lefty01/ESP32_TTGO_FTMS/doc/esp32_treadmill_sensor_proto.jpg

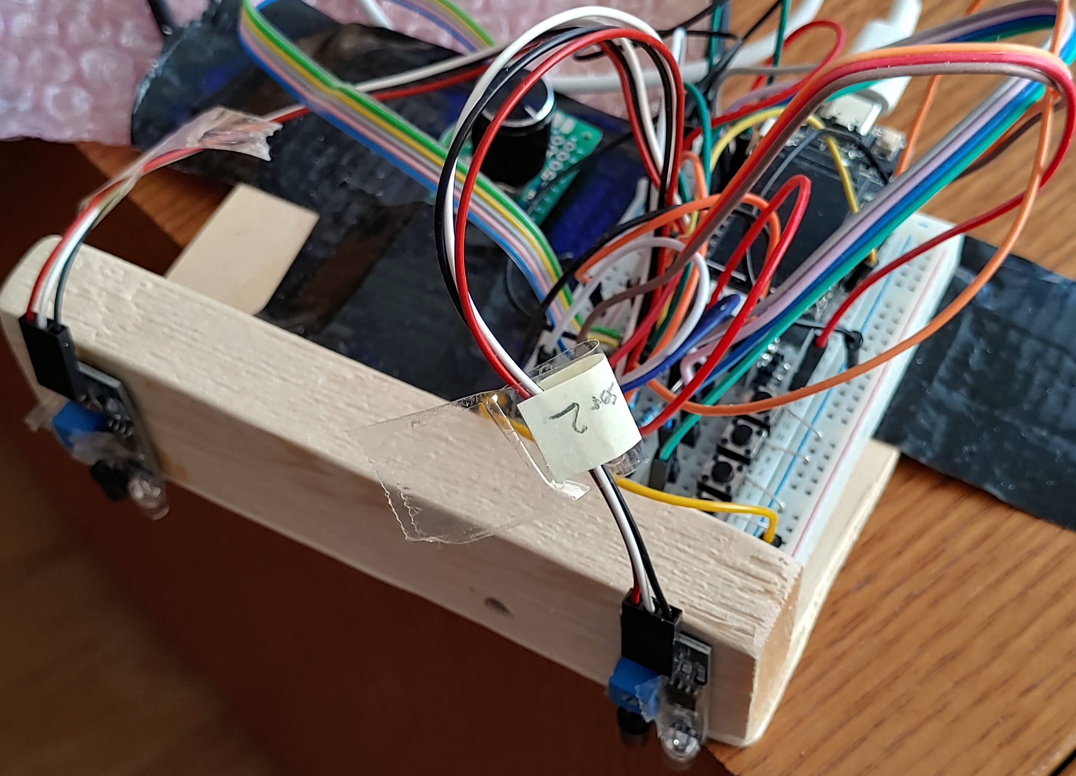
doc/esp32_treadmill_sensor_proto.jpg
