lefty01/ESP32_TTGO_FTMS/doc/taurus_incline_angle.png

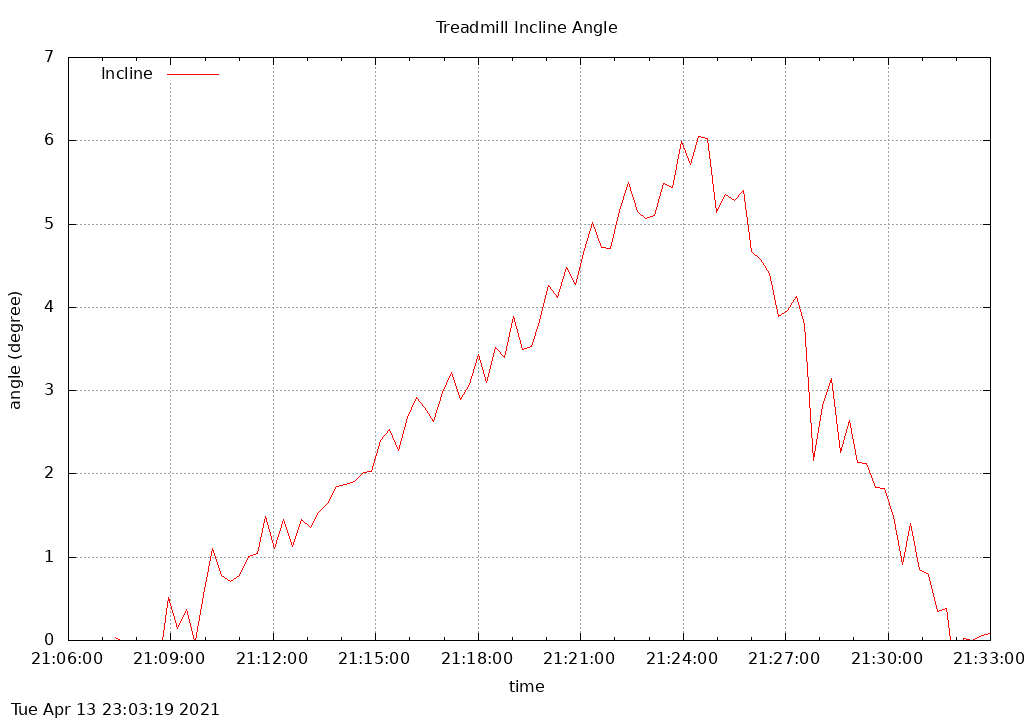
doc/taurus_incline_angle.png
