lefty01/ESP32_TTGO_FTMS/doc/taurus_incline_dist_tof.png

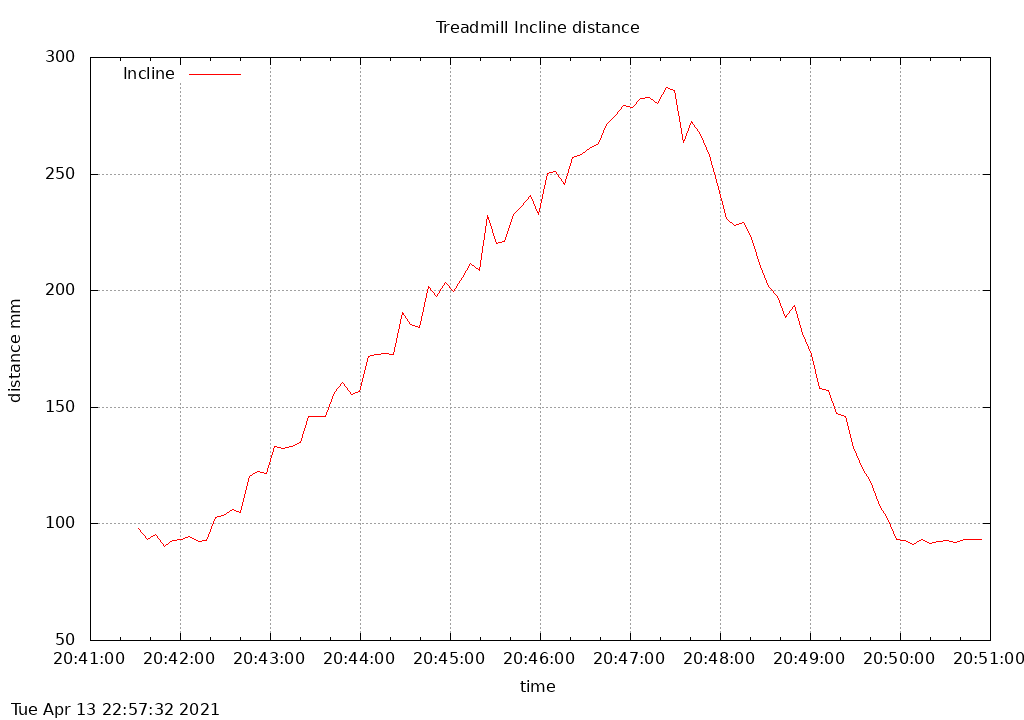
doc/taurus_incline_dist_tof.png
