lefty01/ESP32_TTGO_FTMS/doc/measurement-kmh-vs-time.ods

Sheet: Sheet1
Speed [km/h] | Time [ms] | Distance [] | Speed [m/s] | Time [s] | Dist [m] | mm | us | P | f | t high | t low
22 | 40.8 | 897.6 | 6.11 | 0.0408 | 0.249333333333333 |  | 40800
20 | 45 | 900 | 5.56 | 0.045 | 0.25 |  | 45000
16 | 56 | 896 | 4.44 | 0.056 | 0.248888888888889 |  | 56000
12 | 76 | 912 | 3.33 | 0.076 | 0.253333333333333 |  | 76000
10 | 90.4 | 904 | 2.78 | 0.0904 | 0.251111111111111 |  | 90400
8 | 112.8 | 902.4 | 2.22 | 0.1128 | 0.250666666666666 |  | 112800
4 | 225 | 900 | 1.11 | 0.225 | 0.25 |  | 225000
2 | 450 | 900 | 0.56 | 0.45 | 0.25 |  | 450000
1 | 900 | 900 | 0.28 | 0.9 | 0.25 |  | 900000
0.5 | 1840 | 920 | 0.14 | 1.84 | 0.255555555555556 |  | 1840000
 |  |  |  |  | 0.250888888888889 | 250.888888888889

Sheet: Sheet2
25378510
25557209 | 178699
25557210 | 1
25557212 | 2
25557237 | 25
27205747 | 1648510
27386274 | 180527
27386291 | 17
