lefty01/ESP32_TTGO_FTMS/(threads)

Thread 4 (2021-08-02):

MPU6050 init fail caused constant 15% incline to be reported

lefty01, 2021-08-02:
if MPU6050 fails to init we are able to manually set elevation ( that basically works,) but in my case it reported constant 15% incline which I didn't notice ... check the code!

lefty01, 2023-01-06:
so I think this is also not an issue anymore. if something pops up again lets open a new issue

Closed 2023-01-06.

Thread 14 (2022-02-03):

Building the Project - slight problems

Joeee83, 2022-02-03:
Hi there,
i just ordered a threadmill, but it is without bluetooth support. So i searched the internet and found this great project.
All the eletronic parts are here, so I started out by following your beginners guide. In addition to that I added a profile for my threadmill. (Without the real diameter for the roll)
So far its just the TTGO ESP32 running the website, connecting to my mqtt server. All working fine. The next thing I tried was to connect it to my smartphone (S10+) via BLE. In the Bluetooth settings i can connect the android os to the module. But I can't find the threadmill in an app. (zwift nor kinomap)
What am i doing wrong?
Do sensors have to be connected befor connecting to the software?
Any help is apreciated. TIA

Joe

lefty01, 2022-02-03:
Hi, nope the BLE server part should work regardless of any sensors. That's how I started just adjusting the speed and incline manually ( cumbersome but works).
So that said it's hard to predict what might be wrong. Are you running zwift on the android? It will tell you to turn on location server I guess you did that?
What I used in the beginning was the nrf connect app:
https://play.google.com/store/apps/details?id=no.nordicsemi.android.mcp&hl=en_US&gl=US
you can try this first and see if it connects to the ESP32 (shoud advertise as FTMS something)
if you can connect via this app you should be able to read speed for example as shown here:

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

if that does not work ... it's hard to predict ... I would then try to add some debug with this function:
void initBLE() {
...
  tft.println("initBLE");
...
and see if there's any error in setting up bluetooth.

are you using the (now default) NimbleBLE ... you would unless you undefined it in the source.

lefty01, 2022-02-03:
cool. also interesting you can see your treadmill as BT device, which model is it btw?

as for the "rotation" sensor ... usually you should be able to open the motor "room" of your treadmill ... also required to clean up the dust in there once in a while.  most likely you will see the motor that drives the front belt wheel via some strap. within that belt wheel there's usually one or even two magnets ... then there is the reed switch with some cable going to the control unit.
that is the thing detecting each wheel turn. I can see two options here a) use the existing sensor and use wires in parallel
or b) what I did buy extra reed sensor and mount it next to the existing one ( I used some hot glue) I have some 10k pull-up resistor that connects one wire of the sensor to the gpio pin.
hint: google image search treadmill speed sensor

before that I used the two IR-Sensors and had marked the belt (same concept as the RunN sensor) that should work as well ... but it's a  more "shaky" then the reed sensor readings.

let me know how things are going. so maybe we can close this issue? just open new one for anything that pops up.

zingo, 2022-02-03:
On my treadmill a Northtrack 12.2 Si, but this will probably be true for all MC2100ELS based models (a popular motor control board) the "rotation" sensor data is going up to the "CPU/Computer" in the console as one of the cables in the harnest as a 5V signal. In my case I just did a Y split of the cable and used a levelshifter from 5v to 3.3V and then connected it to the ESP32.

Joeee83, 2022-02-04:
Hi, yesterday i did some diggin.
The threadmill is a Hometrack HT5000 sold and branded by Miweba in Germany.
I first opend the Motor compartment. As expected from a chinese product wire handling looks a bit wild west, but is surely practical.  (A few connectors needed a push to sit right were they belong.)
The controller PCB is  a JFDZ_PBJ_XKYS_COMST _ V 1,17 and can also be bough as a spare from ali. Only the inclination seems to have a closed loop design. For the drive motor i can't see any feedback to the pcb. But the DC labeled motor has dual shafts. On one side there is a poly-V-belt and on the other side ther is a slotted disc. I can also see 2xM4 in the motors die cast housing for attaching a light barrier to it. This would be a managable job for me, as i can design and print 3d FDM parts. But doing so would give a much higher frequency of interrupts to the ESP. As i didn't find a bluetooth chip in there i had a look at the user interface PCB in the top of the machine.
It is build like a configurable motherboard for different modules with the display on its back. On the PCB there is: A Chip for determining the pulse of the user(SH601), a 32k Flash (HC16LC16) , a RAM Mapping 48x8 LCD Controller (HT1623) some audio and level shifting stuff as well as a BLE SoC CMT4502 from HOPERF. Its connector is labeld as GND, RX, TX, GND. The foiled buttons seem to be connected in a 5x4 matrix style to the PCB. The controller PCB is connected by 5 wires.
From here I have to decide what to do:
I could try to sniff the serial line to the bluetooth module. This would surely be the most elegant way for a ble retrofit. It questionable if there is communcation when the app doesn't connect to it. The thing is - when I scan the QR code on the machine it forwards me to an app in the play store. I installed it but didn't allow permissions for the local files. So this doesn't work atm. It questionable if there is communcation when the app doesn't connect to it. Unless i find an older of my phones with ble but without my private files.
Goind the factory RXTX way has the risk of not understanding the communication but also doesn't seem to give me the real speed.

i think this could be closed as my connection problem to the project is solved. I could post updates on my attemp here if you like it.  You can decide.

lefty01, 2022-02-04:
Hey ... thanks a lot for sharing this info!  so if this project by any chance will further mature it's good to know more about different treadmill types.
from reading the treadmill description of this model it could very well be that the designed BT interface is kind of unidirectional such that the training app  sends speed and incline to the treadmill only. but would be kind of surprising if there's no return signal to get "real" incline/speed back to the app. at one point this sounds pretty cool as it could open up a whole bunch of new possibilities (eg. grab incline from zwift and forward to treadmill) without further wiring .... BUT maybe reversing the protocol isn't straight forward.

So is your thinking that you might see speed and incline values on the Tx pin? so eg. read serial line via an ESP32 and than transmit as fitness machine data?

lefty01, 2022-02-04:
... btw maybe we can use the wiki to document different treadmill models.

zingo, 2022-02-04:
Was thinking about the wiki also, it would be good for each new person to find the different findings and ideas to fix them.

Joeee83, 2022-02-04:
The advertisment states: "Mit ihr werden Werte wie die Laufgeschwindigkeit via Smartphone an Ihr individuelles Trainingsziel angepasst." With the app values as running speed are adjusted to your individual training goal via Smartphone. I also took pictures of the inner parts.

zingo, 2022-02-04:
Nice I see you have already started :) Do you want us to edit wiki's in out fork or directly here, if so we need permission :)
Im not sure the wiki parts can be merged easy to/from forks but if it is I don't mind using the fork, whatever you think is best/easiest for you.

lefty01, 2022-02-04:
I would think it's easier to edit the wiki directly instead of forking it and add pull-requests. as collaborator you should have been able to edit it already ;)
I now removed the wiki access restriction so anyone with an github account should be able to edit/add pages.
... hoping there won't be offensive or otherwise inappropriate content being added.

zingo, 2022-02-04:
I didn't have any edit button before but it poped up now, thanks.
`... hoping there won't be offensive or otherwise inappropriate content being added.`
If that starts to happen we can always close it then.

lefty01, 2022-02-07:
closing ... as discussed

Closed 2022-02-07.

Thread 19 (2022-02-09):

Not able to pair with Zwift om computer

beer-rich, 2022-02-09:
Hi. I have used this with The Zwift Companion app on my phone successfully. But I am unable to get my computer to show the esp threadmill ingame. I have confirmed the PC has BLE and that ut is able to see the ESP in the "add bluetooth device wizard". Having ut on the computer would make it a lot easier to use for multiple users. Any help is appreciated.

lefty01, 2022-02-10:
Hi ... not sure if I can help. But how is you setting in the Zwift app on your PC (is it windows PC?)?
you can choose connect via built-in bluetooth or connect via Zwift companion.
On windows PC zwift I use the setting "built-in bluetooth" that works for me. I would think it is even a bit more "stable" connection then with my android phone.

have you played with these two options within zwift?  IIRC I did not pair the ESP with windows (like adding a bt device or something ... so maybe  you can try unpari from PC again then start Zwift and try use built-in bluetooth?? )

beer-rich, 2022-02-10:
Thanks for the quick reply and confirming this should work.

Yeah, its set to built in - I can pair with Heart Rate BLE Strap for instance.

I tried playing with unpairing/paring etc., but no difference.

Probably something with my computer then atleast.
Do you see the same BLE capabilites on your bluetooth device on your computer that is working?

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

lefty01, 2022-02-14:
as far as I can see this looks same here.

lefty01, 2022-02-17:
any success? any chance to try another PC and/or ESP board? not sure if you could enable some ESP Core debug function that could help debug the connection issue. or maybe some debug  prints  within the bluetooth code?
one other thing that came to my mind since I was wondering if we could cleanup the bluetooth and stick with only the "NimBLE" stack ... at this point you might be able to undefine NIMBLE in the code an run with the BLEDevice instead of NimBLEDevice ... although I doubt that it would make a difference

beer-rich, 2022-03-23:
Finally got to try with another ESP board and I have no issues now. Closing the issue.

lefty01, 2022-03-27:
cool thx for the update

Closed 2022-03-23.

Thread 24 (2022-07-28):

[Feature request] Adding RSCP (foot-pod) broadcast mode?

fyksen, 2022-07-28:
Hello. Love this project!
Some people don't want to use Zwift, but want to track distance on garmin watches. Garmin does not support FTMS from treadmill, so many people are left buying devices like the bulky and pricy NPE runn.

Would it be possible to add a feature that just sends [RSCP](https://www.bluetooth.org/docman/handlers/downloaddoc.ashx?doc_id=261266)

lefty01, 2022-08-01:
interesting point, right now I still use my garmin to record (and transmit to zwift) cadence for example .. and in virtual running mode (same as for the treadmill mode I think) the watch  records the pace that it measures from the arm movement.

so basically I already thought of having this ESP32 FTMS  measure cadence as well (but with the MPU6050 it should not be a big deal) and then also transmit the speed back to garmin watch....

as time permits I will take a closer look at this.

fyksen, 2022-08-17:
Very cool. Thanks!

lefty01, 2023-01-06:
sorry still pending.
but I really would like to add cadence any way at some point in time.
right now we are doing some (re-) work on this project anyway so maybe that helps keep up the pace ;))

fyksen, 2023-01-07:
No problem! Thanks for the update!

MartinGranados, 2024-09-27:
Hello, any update on this?

Im using a more basic version of this project, and it advertises itself as a footpad. Zwift supports the footpad, and my Garmin Tactix Delta (aka Fenix 6 series) can find it.

One benefit of the FTMS mode is that it can also pair with the Peloton app and display metrics on the apps workout display

I want my wife to be able to use the treadmill with peloton, and occasionally I will use the treadmill with Zwift, but sometimes id like to just run with music and a tv show on and just record straight to my watch.

Im wondering if its possible to have the one device broadcast multiple services so that for example, my watch can connect to the footpath (Run Speed/Cadence service) while Zwift or Peloton connect to the FTMS service

If this was python I could help, but I never learned C unfortunately haha so although I can KINDA poke around and figure things out, I sometimes mess the whole thing up and have to Ctrl-Z it all away

Thread 25 (2022-09-20):

more thanone instance of overloaded function "TwoWire::begin matches the argument list

smitec11, 2022-09-20:
in ESP32_TTGO_FTMS.cpp line 1101:

I2C_0.begin(SDA_0 , SCL_0 , I2C_FREQ);

will give error when building.

should be :

I2C_0.begin(SDA_0 , SCL_0 , (uint32_t) I2C_FREQ);

zingo, 2022-09-20:
Thanks for reporting!
I made this on my fork
https://github.com/zingo/ESP32_TTGO_FTMS/commit/6f0deaaba267e80c204e0c5f4158d71cfe72a7b8
a while ago I think it will solve this for you.

I created this pull request for this repo
https://github.com/lefty01/ESP32_TTGO_FTMS/pull/26

smitec11, 2022-09-20:
welcome.

can you contact me on the pm I send you? regards, Chris

zingo, 2022-09-20:
No problem but I can't find it but I also have not used PM in github before :)
Is the one in gitter from 22 Aug?
https://gitter.im/lefty01/ESP32_TTGO_FTMS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

lefty01, 2022-09-21:
merged #26
@zingo also note this commit: https://github.com/lefty01/ESP32_TTGO_FTMS/commit/cd9e4a1a89b27e7d2adb48c9d349f63fd03d7649
fixes the same issue for tagert ttgo-T4

smitec11, 2022-09-22:
@zingo,  I used gitter for the PM.

Closed 2022-09-21.

Thread 36 (2024-11-30):

Build failures 'SemaphoreHandle_t' does not name a type

cprasmu, 2024-11-30:
I'm guessing this is due to the boad api changes over time but I'm getting error: 'SemaphoreHandle_t' does not name a type. when trying to build. I also found that the AsyncElegantOTA library has been deprecated for ElegantOTA - I'm not sure if any code changes are required to move to this library?

lefty01, 2024-11-30:
Hrmm...good point. Since my device works pretty well there was not much need to keep track of lib updates. But I'll check if switching ota lib could be done without too much effort.

cprasmu, 2024-11-30:
Thanks that would be great!

Peter

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

cprasmu, 2024-12-02:
It’s the TTGO T-Display  esp32 , not home at the moment but just tried to
build from the pio build menu.

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

lefty01, 2024-12-02:
I tried switching to ElegantOTA here
https://github.com/lefty01/ESP32_TTGO_FTMS/tree/libupdate_dev
for me I think the targets are at least compiling. maybe you could try checkout that branch.
but you probably need to remove .pio completly (at least libdeps)
there's some issue with ESPAsyncWebServer-esphome vs ESPAsyncWebServer (not sure why we had -esphome version in the first place maybe I wanted homeassitant mqtt config or something like that???) if ESPAsyncWebServer-esphome is used then I think ESPAsyncWebServer is still downloaded as dependency and that cause error that some stuff is defined twice.
but I have not flashed anything and therefore not tested ota or if it works at all
```
Environment                  Status    Duration
---------------------------  --------  ------------
ESP32_TTGO_DISPLAY           SUCCESS   00:00:32.024
ESP32_TTGO_DISPLAY_SSL       SUCCESS   00:00:32.767
ESP32_WT32-SC01              SUCCESS   00:00:32.779
ESP32_WT32-SC01_OLD_TFT_GUI  SUCCESS   00:00:25.911
ESP32_TTGO_T4                SUCCESS   00:00:49.079
ESP32_WROOMD_HEADLESS        SUCCESS   00:00:18.313
```

lefty01, 2024-12-02:
if you see the SemaphoreHandle_t build error can you paste the complete compile output?

cprasmu, 2024-12-03:
I'm not sure if I have something wrong on my machine, but this is the output of just trying to build the ESP32_TTGO_DISPLAY target. building in vscode on macos Sequoia 15.0.1, 3.7 GHz 6-Core Intel Core i5

 *  Executing task: platformio run --environment ESP32_TTGO_DISPLAY

Processing ESP32_TTGO_DISPLAY (platform: espressif32; board: esp32dev; framework: arduino)
-----------------------------------------------------------------------------------------------------------------------------------------------------------------------------------------------------------------------------------------------------------------------------------
Verbose mode can be enabled via `-v, --verbose` option
CONFIGURATION: https://docs.platformio.org/page/boards/espressif32/esp32dev.html
PLATFORM: Espressif 32 (2023.12.10) > Espressif ESP32 Dev Module
HARDWARE: ESP32 240MHz, 320KB RAM, 4MB Flash
DEBUG: Current (cmsis-dap) External (cmsis-dap, esp-bridge, esp-prog, iot-bus-jtag, jlink, minimodule, olimex-arm-usb-ocd, olimex-arm-usb-ocd-h, olimex-arm-usb-tiny-h, olimex-jtag-tiny, tumpa)
PACKAGES:
 - framework-arduinoespressif32 @ 3.0.0
 - tool-cmake @ 3.21.3
 - tool-esptoolpy @ 1.40700.0+dev4 (4.7.0)
 - tool-mklittlefs @ 3.2.0
 - tool-mkspiffs @ 2.230.0 (2.30)
 - tool-ninja @ 1.9.0
 - tool-riscv32-esp-elf-gdb @ 12.1.0+20221002
 - tool-xtensa-esp-elf-gdb @ 12.1.0+20221002
 - toolchain-esp32ulp @ 1.23500.220830 (2.35.0)
 - toolchain-xtensa-esp32 @ 12.2.0+20230208
LDF: Library Dependency Finder -> https://bit.ly/configure-pio-ldf
LDF Modes: Finder ~ chain, Compatibility ~ soft
Found 35 compatible libraries
Scanning dependencies...
Dependency Graph
|-- NimBLE-Arduino @ 1.4.3
|-- PubSubClient @ 2.8.0
|-- ArduinoJson @ 6.21.5
|-- Button2 @ 2.3.3
|-- Time @ 1.6.1
|-- MPU6050_light @ 1.1.0
|-- ESPAsyncWiFiManager @ 0.31.0+sha.3b9a58a
|-- ElegantOTA @ 3.1.6
|-- LovyanGFX @ 1.2.0
|-- lvgl @ 8.4.0
|-- ESPAsyncWebServer @ 3.3.23
|-- AsyncTCP @ 3.2.14
|-- LittleFS @ 2.0.0
|-- Preferences @ 2.0.0
|-- SPI @ 2.0.0
|-- Wire @ 2.0.0
|-- DNSServer @ 2.0.0
|-- WiFi @ 2.0.0
Building in release mode
Compiling .pio/build/ESP32_TTGO_DISPLAY/lib62e/LovyanGFX/lgfx/Fonts/IPA/lgfx_font_japan.c.o
Compiling .pio/build/ESP32_TTGO_DISPLAY/lib62e/LovyanGFX/lgfx/Fonts/efont/lgfx_efont_cn.c.o
Compiling .pio/build/ESP32_TTGO_DISPLAY/lib62e/LovyanGFX/lgfx/Fonts/efont/lgfx_efont_ja.c.o
Compiling .pio/build/ESP32_TTGO_DISPLAY/lib62e/LovyanGFX/lgfx/Fonts/efont/lgfx_efont_kr.c.o
Compiling .pio/build/ESP32_TTGO_DISPLAY/lib62e/LovyanGFX/lgfx/Fonts/efont/lgfx_efont_tw.c.o
Compiling .pio/build/ESP32_TTGO_DISPLAY/lib62e/LovyanGFX/lgfx/utility/lgfx_miniz.c.o
Compiling .pio/build/ESP32_TTGO_DISPLAY/lib62e/LovyanGFX/lgfx/utility/lgfx_pngle.c.o
Compiling .pio/build/ESP32_TTGO_DISPLAY/lib62e/LovyanGFX/lgfx/utility/lgfx_qoi.c.o
Compiling .pio/build/ESP32_TTGO_DISPLAY/lib62e/LovyanGFX/lgfx/utility/lgfx_qrcode.c.o
Compiling .pio/build/ESP32_TTGO_DISPLAY/lib62e/LovyanGFX/lgfx/utility/lgfx_tjpgd.c.o
Compiling .pio/build/ESP32_TTGO_DISPLAY/lib62e/LovyanGFX/lgfx/v1/LGFXBase.cpp.o
Compiling .pio/build/ESP32_TTGO_DISPLAY/lib62e/LovyanGFX/lgfx/v1/LGFX_Button.cpp.o
Compiling .pio/build/ESP32_TTGO_DISPLAY/lib62e/LovyanGFX/lgfx/v1/LGFX_Sprite.cpp.o
Compiling .pio/build/ESP32_TTGO_DISPLAY/lib62e/LovyanGFX/lgfx/v1/lgfx_fonts.cpp.o
Compiling .pio/build/ESP32_TTGO_DISPLAY/lib62e/LovyanGFX/lgfx/v1/misc/DividedFrameBuffer.cpp.o
Compiling .pio/build/ESP32_TTGO_DISPLAY/lib62e/LovyanGFX/lgfx/v1/misc/SpriteBuffer.cpp.o
Compiling .pio/build/ESP32_TTGO_DISPLAY/lib62e/LovyanGFX/lgfx/v1/misc/common_function.cpp.o
Compiling .pio/build/ESP32_TTGO_DISPLAY/lib62e/LovyanGFX/lgfx/v1/misc/pixelcopy.cpp.o
Compiling .pio/build/ESP32_TTGO_DISPLAY/lib62e/LovyanGFX/lgfx/v1/panel/Panel_Device.cpp.o
Compiling .pio/build/ESP32_TTGO_DISPLAY/lib62e/LovyanGFX/lgfx/v1/panel/Panel_FlexibleFrameBuffer.cpp.o
Compiling .pio/build/ESP32_TTGO_DISPLAY/lib62e/LovyanGFX/lgfx/v1/panel/Panel_FrameBufferBase.cpp.o
Compiling .pio/build/ESP32_TTGO_DISPLAY/lib62e/LovyanGFX/lgfx/v1/panel/Panel_GDEW0154M09.cpp.o
Compiling .pio/build/ESP32_TTGO_DISPLAY/lib62e/LovyanGFX/lgfx/v1/panel/Panel_HUB75.cpp.o
Compiling .pio/build/ESP32_TTGO_DISPLAY/lib62e/LovyanGFX/lgfx/v1/panel/Panel_HasBuffer.cpp.o
Compiling .pio/build/ESP32_TTGO_DISPLAY/lib62e/LovyanGFX/lgfx/v1/panel/Panel_ILI9225.cpp.o
Compiling .pio/build/ESP32_TTGO_DISPLAY/lib62e/LovyanGFX/lgfx/v1/panel/Panel_IT8951.cpp.o
Compiling .pio/build/ESP32_TTGO_DISPLAY/lib62e/LovyanGFX/lgfx/v1/panel/Panel_LCD.cpp.o
Compiling .pio/build/ESP32_TTGO_DISPLAY/lib62e/LovyanGFX/lgfx/v1/panel/Panel_M5HDMI.cpp.o
Compiling .pio/build/ESP32_TTGO_DISPLAY/lib62e/LovyanGFX/lgfx/v1/panel/Panel_M5UnitGLASS.cpp.o
Compiling .pio/build/ESP32_TTGO_DISPLAY/lib62e/LovyanGFX/lgfx/v1/panel/Panel_M5UnitLCD.cpp.o
Compiling .pio/build/ESP32_TTGO_DISPLAY/lib62e/LovyanGFX/lgfx/v1/panel/Panel_NT35510.cpp.o
Compiling .pio/build/ESP32_TTGO_DISPLAY/lib62e/LovyanGFX/lgfx/v1/panel/Panel_RA8875.cpp.o
Compiling .pio/build/ESP32_TTGO_DISPLAY/lib62e/LovyanGFX/lgfx/v1/panel/Panel_RM68120.cpp.o
Compiling .pio/build/ESP32_TTGO_DISPLAY/lib62e/LovyanGFX/lgfx/v1/panel/Panel_SSD1306.cpp.o
Compiling .pio/build/ESP32_TTGO_DISPLAY/lib62e/LovyanGFX/lgfx/v1/panel/Panel_SSD1327.cpp.o
Compiling .pio/build/ESP32_TTGO_DISPLAY/lib62e/LovyanGFX/lgfx/v1/panel/Panel_SSD1331.cpp.o
Compiling .pio/build/ESP32_TTGO_DISPLAY/lib62e/LovyanGFX/lgfx/v1/panel/Panel_SSD1351.cpp.o
Compiling .pio/build/ESP32_TTGO_DISPLAY/lib62e/LovyanGFX/lgfx/v1/panel/Panel_SSD1963.cpp.o
Compiling .pio/build/ESP32_TTGO_DISPLAY/lib62e/LovyanGFX/lgfx/v1/platforms/arduino_default/Bus_SPI.cpp.o
Compiling .pio/build/ESP32_TTGO_DISPLAY/lib62e/LovyanGFX/lgfx/v1/platforms/arduino_default/Bus_Stream.cpp.o
Compiling .pio/build/ESP32_TTGO_DISPLAY/lib62e/LovyanGFX/lgfx/v1/platforms/arduino_default/common.cpp.o
Compiling .pio/build/ESP32_TTGO_DISPLAY/lib62e/LovyanGFX/lgfx/v1/platforms/esp32/Bus_HUB75.cpp.o
Compiling .pio/build/ESP32_TTGO_DISPLAY/lib62e/LovyanGFX/lgfx/v1/platforms/esp32/Bus_I2C.cpp.o
Compiling .pio/build/ESP32_TTGO_DISPLAY/lib62e/LovyanGFX/lgfx/v1/platforms/esp32/Bus_Parallel8.cpp.o
Compiling .pio/build/ESP32_TTGO_DISPLAY/lib62e/LovyanGFX/lgfx/v1/platforms/esp32/Bus_SPI.cpp.o
Compiling .pio/build/ESP32_TTGO_DISPLAY/lib62e/LovyanGFX/lgfx/v1/platforms/esp32/Light_PWM.cpp.o
Compiling .pio/build/ESP32_TTGO_DISPLAY/lib62e/LovyanGFX/lgfx/v1/platforms/esp32/Panel_CVBS.cpp.o
Compiling .pio/build/ESP32_TTGO_DISPLAY/lib62e/LovyanGFX/lgfx/v1/platforms/esp32/common.cpp.o
Compiling .pio/build/ESP32_TTGO_DISPLAY/lib62e/LovyanGFX/lgfx/v1/platforms/esp32c3/Bus_Parallel8.cpp.o
Compiling .pio/build/ESP32_TTGO_DISPLAY/lib62e/LovyanGFX/lgfx/v1/platforms/esp32s2/Bus_Parallel16.cpp.o
Compiling .pio/build/ESP32_TTGO_DISPLAY/lib62e/LovyanGFX/lgfx/v1/platforms/esp32s2/Bus_Parallel8.cpp.o
Compiling .pio/build/ESP32_TTGO_DISPLAY/lib62e/LovyanGFX/lgfx/v1/platforms/esp32s3/Bus_Parallel16.cpp.o
Compiling .pio/build/ESP32_TTGO_DISPLAY/lib62e/LovyanGFX/lgfx/v1/platforms/esp32s3/Bus_Parallel8.cpp.o
Compiling .pio/build/ESP32_TTGO_DISPLAY/lib62e/LovyanGFX/lgfx/v1/platforms/esp32s3/Bus_RGB.cpp.o
Compiling .pio/build/ESP32_TTGO_DISPLAY/lib62e/LovyanGFX/lgfx/v1/platforms/esp32s3/Panel_RGB.cpp.o
Compiling .pio/build/ESP32_TTGO_DISPLAY/lib62e/LovyanGFX/lgfx/v1/platforms/esp8266/Bus_I2C.cpp.o
Compiling .pio/build/ESP32_TTGO_DISPLAY/lib62e/LovyanGFX/lgfx/v1/platforms/esp8266/Bus_SPI.cpp.o
Compiling .pio/build/ESP32_TTGO_DISPLAY/lib62e/LovyanGFX/lgfx/v1/platforms/esp8266/common.cpp.o
Compiling .pio/build/ESP32_TTGO_DISPLAY/lib62e/LovyanGFX/lgfx/v1/platforms/framebuffer/Panel_fb.cpp.o
Compiling .pio/build/ESP32_TTGO_DISPLAY/lib62e/LovyanGFX/lgfx/v1/platforms/framebuffer/common.cpp.o
Compiling .pio/build/ESP32_TTGO_DISPLAY/lib62e/LovyanGFX/lgfx/v1/platforms/opencv/Panel_OpenCV.cpp.o
Compiling .pio/build/ESP32_TTGO_DISPLAY/lib62e/LovyanGFX/lgfx/v1/platforms/opencv/common.cpp.o
Compiling .pio/build/ESP32_TTGO_DISPLAY/lib62e/LovyanGFX/lgfx/v1/platforms/rp2040/Bus_I2C.cpp.o
Compiling .pio/build/ESP32_TTGO_DISPLAY/lib62e/LovyanGFX/lgfx/v1/platforms/rp2040/Bus_SPI.cpp.o
Compiling .pio/build/ESP32_TTGO_DISPLAY/lib62e/LovyanGFX/lgfx/v1/platforms/rp2040/Light_PWM.cpp.o
Compiling .pio/build/ESP32_TTGO_DISPLAY/lib62e/LovyanGFX/lgfx/v1/platforms/rp2040/common.cpp.o
Compiling .pio/build/ESP32_TTGO_DISPLAY/lib62e/LovyanGFX/lgfx/v1/platforms/samd21/Bus_I2C.cpp.o
Compiling .pio/build/ESP32_TTGO_DISPLAY/lib62e/LovyanGFX/lgfx/v1/platforms/samd21/Bus_SPI.cpp.o
Compiling .pio/build/ESP32_TTGO_DISPLAY/lib62e/LovyanGFX/lgfx/v1/platforms/samd21/common.cpp.o
Compiling .pio/build/ESP32_TTGO_DISPLAY/lib62e/LovyanGFX/lgfx/v1/platforms/samd51/Bus_I2C.cpp.o
Compiling .pio/build/ESP32_TTGO_DISPLAY/lib62e/LovyanGFX/lgfx/v1/platforms/samd51/Bus_SPI.cpp.o
Compiling .pio/build/ESP32_TTGO_DISPLAY/lib62e/LovyanGFX/lgfx/v1/platforms/samd51/common.cpp.o
Compiling .pio/build/ESP32_TTGO_DISPLAY/lib62e/LovyanGFX/lgfx/v1/platforms/sdl/Panel_sdl.cpp.o
Compiling .pio/build/ESP32_TTGO_DISPLAY/lib62e/LovyanGFX/lgfx/v1/platforms/sdl/common.cpp.o
Compiling .pio/build/ESP32_TTGO_DISPLAY/lib62e/LovyanGFX/lgfx/v1/platforms/spresense/Bus_SPI.cpp.o
Compiling .pio/build/ESP32_TTGO_DISPLAY/lib62e/LovyanGFX/lgfx/v1/platforms/spresense/common.cpp.o
Compiling .pio/build/ESP32_TTGO_DISPLAY/lib62e/LovyanGFX/lgfx/v1/platforms/stm32/Bus_SPI.cpp.o
Compiling .pio/build/ESP32_TTGO_DISPLAY/lib62e/LovyanGFX/lgfx/v1/platforms/stm32/common.cpp.o
Compiling .pio/build/ESP32_TTGO_DISPLAY/lib62e/LovyanGFX/lgfx/v1/touch/Touch_CST816S.cpp.o
Compiling .pio/build/ESP32_TTGO_DISPLAY/lib62e/LovyanGFX/lgfx/v1/touch/Touch_FT5x06.cpp.o
Compiling .pio/build/ESP32_TTGO_DISPLAY/lib62e/LovyanGFX/lgfx/v1/touch/Touch_GSLx680.cpp.o
Compiling .pio/build/ESP32_TTGO_DISPLAY/lib62e/LovyanGFX/lgfx/v1/touch/Touch_GT911.cpp.o
Compiling .pio/build/ESP32_TTGO_DISPLAY/lib62e/LovyanGFX/lgfx/v1/touch/Touch_NS2009.cpp.o
Compiling .pio/build/ESP32_TTGO_DISPLAY/lib62e/LovyanGFX/lgfx/v1/touch/Touch_RA8875.cpp.o
Compiling .pio/build/ESP32_TTGO_DISPLAY/lib62e/LovyanGFX/lgfx/v1/touch/Touch_STMPE610.cpp.o
Compiling .pio/build/ESP32_TTGO_DISPLAY/lib62e/LovyanGFX/lgfx/v1/touch/Touch_TT21xxx.cpp.o
Compiling .pio/build/ESP32_TTGO_DISPLAY/lib62e/LovyanGFX/lgfx/v1/touch/Touch_XPT2046.cpp.o
Compiling .pio/build/ESP32_TTGO_DISPLAY/src/ESP32_TTGO_FTMS.cpp.o
Compiling .pio/build/ESP32_TTGO_DISPLAY/src/config.cpp.o
Compiling .pio/build/ESP32_TTGO_DISPLAY/src/display.cpp.o
src/ESP32_TTGO_FTMS.cpp:66:2: warning: #warning todo cs:putback gfxlogtext [-Wcpp]
   66 | #warning todo cs:putback gfxlogtext
      |  ^~~~~~~
Compiling .pio/build/ESP32_TTGO_DISPLAY/src/gui-LVGL.cpp.o
Compiling .pio/build/ESP32_TTGO_DISPLAY/src/gui-tft.cpp.o
Compiling .pio/build/ESP32_TTGO_DISPLAY/src/hardware.cpp.o
In file included from src/display.cpp:2:
include/common.h:75:6: error: variable or field 'logText' declared void
   75 | void logText(std::string text);
      |      ^~~~~~~
include/common.h:75:19: error: 'string' is not a member of 'std'
   75 | void logText(std::string text);
      |                   ^~~~~~
include/common.h:1:1: note: 'std::string' is defined in header '<string>'; did you forget to '#include <string>'?
  +++ |+#include <string>
    1 | #ifndef _ESP32_TTGO_FTMS_H_
src/ESP32_TTGO_FTMS.cpp: In function 'void speedUp()':
src/ESP32_TTGO_FTMS.cpp:113:5: error: 'handleEvent' was not declared in this scope
  113 |     handleEvent(EventType::TREADMILL_SPEED_UP);
      |     ^~~~~~~~~~~
src/ESP32_TTGO_FTMS.cpp: In function 'void speedDown()':
src/ESP32_TTGO_FTMS.cpp:128:5: error: 'handleEvent' was not declared in this scope
  128 |     handleEvent(EventType::TREADMILL_SPEED_DOWN);
      |     ^~~~~~~~~~~
src/ESP32_TTGO_FTMS.cpp: In function 'void inclineUp()':
src/ESP32_TTGO_FTMS.cpp:143:5: error: 'handleEvent' was not declared in this scope
  143 |     handleEvent(EventType::TREADMILL_INC_UP);
      |     ^~~~~~~~~~~
src/ESP32_TTGO_FTMS.cpp: In function 'void inclineDown()':
src/ESP32_TTGO_FTMS.cpp:160:5: error: 'handleEvent' was not declared in this scope
  160 |     handleEvent(EventType::TREADMILL_INC_DOWN);
      |     ^~~~~~~~~~~
src/ESP32_TTGO_FTMS.cpp: In function 'void showInfo()':
src/ESP32_TTGO_FTMS.cpp:213:50: error: 'GPIOExtender' was not declared in this scope
  213 |              String(" GPIOExtender(AW9523): ") + GPIOExtender.isAvailable() + String("\n");
      |                                                  ^~~~~~~~~~~~
src/ESP32_TTGO_FTMS.cpp: In function 'void setup()':
src/ESP32_TTGO_FTMS.cpp:237:3: error: 'initButton' was not declared in this scope; did you mean 'initMqtt'?
  237 |   initButton();
      |   ^~~~~~~~~~
      |   initMqtt
src/ESP32_TTGO_FTMS.cpp:240:3: error: 'initHardware' was not declared in this scope; did you mean 'MockHardware'?
  240 |   initHardware();
      |   ^~~~~~~~~~~~
      |   MockHardware
src/ESP32_TTGO_FTMS.cpp: In function 'void loop()':
src/ESP32_TTGO_FTMS.cpp:261:3: error: 'loopHandleHardware' was not declared in this scope
  261 |   loopHandleHardware();
      |   ^~~~~~~~~~~~~~~~~~
src/hardware.cpp:249:2: warning: #warning todo cs: add gxloop handler again. [-Wcpp]
  249 | #warning todo cs: add gxloop handler again.
      |  ^~~~~~~
src/hardware.cpp:406:2: warning: #warning check out if this must be here ****************** [-Wcpp]
  406 | #warning check out if this must be here ******************
      |  ^~~~~~~
src/hardware.cpp:416:2: warning: #warning cs todo remove this [-Wcpp]
  416 | #warning cs todo remove this
      |  ^~~~~~~
src/hardware.cpp:448:2: warning: #warning remove this constant to some config/file [-Wcpp]
  448 | #warning remove this constant to some config/file
      |  ^~~~~~~
src/hardware.cpp:604:2: warning: #warning Remove delay and schedule last part later in some way and go back to "main" loop mode. [-Wcpp]
  604 | #warning Remove delay and schedule last part later in some way and go back to "main" loop mode.
      |  ^~~~~~~
src/hardware.cpp:620:2: warning: #warning Remove delay and schedule last part later in some way and go back to "main" loop mode. [-Wcpp]
  620 | #warning Remove delay and schedule last part later in some way and go back to "main" loop mode.
      |  ^~~~~~~
src/ESP32_TTGO_FTMS.cpp:262:3: error: 'loopHandleButton' was not declared in this scope; did you mean 'loopHandleBLE'?
  262 |   loopHandleButton();
      |   ^~~~~~~~~~~~~~~~
      |   loopHandleBLE
src/ESP32_TTGO_FTMS.cpp:268:7: error: 'timer_tick' was not declared in this scope; did you mean 'timer_t'?
  268 |   if (timer_tick == true) {
      |       ^~~~~~~~~~
      |       timer_t
src/ESP32_TTGO_FTMS.cpp:274:17: error: 'getIncline' was not declared in this scope; did you mean 'readIncline'?
  274 |       incline = getIncline(); // sets global 'angle' and 'incline' variable
      |                 ^~~~~~~~~~
      |                 readIncline
src/ESP32_TTGO_FTMS.cpp:289:21: error: 'calculateRPM' was not declared in this scope
  289 |         float rpm = calculateRPM();
      |                     ^~~~~~~~~~~~
Compiling .pio/build/ESP32_TTGO_DISPLAY/src/net-control.cpp.o
src/ESP32_TTGO_FTMS.cpp:292:25: error: 'workoutDistance' was not declared in this scope
  292 |         totalDistance = workoutDistance / 1000;   // conv mm to meter
      |                         ^~~~~~~~~~~~~~~
Building .pio/build/ESP32_TTGO_DISPLAY/bootloader.bin
esptool.py v4.7-dev
Creating esp32 image...
Merged 1 ELF section
Successfully created esp32 image.
Generating partitions .pio/build/ESP32_TTGO_DISPLAY/partitions.bin
*** [.pio/build/ESP32_TTGO_DISPLAY/src/ESP32_TTGO_FTMS.cpp.o] Error 1
*** [.pio/build/ESP32_TTGO_DISPLAY/src/display.cpp.o] Error 1
In file included from src/gui-LVGL.cpp:3:
include/common.h:75:6: error: variable or field 'logText' declared void
   75 | void logText(std::string text);
      |      ^~~~~~~
include/common.h:75:19: error: 'string' is not a member of 'std'
   75 | void logText(std::string text);
      |                   ^~~~~~
include/common.h:14:1: note: 'std::string' is defined in header '<string>'; did you forget to '#include <string>'?
   13 | #include <Arduino.h>
  +++ |+#include <string>
   14 |
In file included from src/hardware.cpp:28:
include/common.h:75:6: error: variable or field 'logText' declared void
   75 | void logText(std::string text);
      |      ^~~~~~~
include/common.h:75:19: error: 'string' is not a member of 'std'
   75 | void logText(std::string text);
      |                   ^~~~~~
include/common.h:1:1: note: 'std::string' is defined in header '<string>'; did you forget to '#include <string>'?
  +++ |+#include <string>
    1 | #ifndef _ESP32_TTGO_FTMS_H_
In file included from .pio/libdeps/ESP32_TTGO_DISPLAY/NimBLE-Arduino/src/NimBLEDevice.h:18,
                 from src/net-control.cpp:26:
.pio/libdeps/ESP32_TTGO_DISPLAY/NimBLE-Arduino/src/nimconfig.h:154: warning: "CONFIG_BT_NIMBLE_ROLE_CENTRAL" redefined
  154 | #define CONFIG_BT_NIMBLE_ROLE_CENTRAL
      |
In file included from /Users/userx/.platformio/packages/framework-arduinoespressif32@src-cdf0adb896be2b73de7b8a8d60c8dc56/tools/esp32-arduino-libs/esp32/include/newlib/platform_include/assert.h:12,
                 from /Users/userx/.platformio/packages/toolchain-xtensa-esp32/xtensa-esp32-elf/sys-include/sys/reent.h:503,
                 from /Users/userx/.platformio/packages/framework-arduinoespressif32@src-cdf0adb896be2b73de7b8a8d60c8dc56/tools/esp32-arduino-libs/esp32/include/newlib/platform_include/sys/reent.h:9,
                 from /Users/userx/.platformio/packages/toolchain-xtensa-esp32/xtensa-esp32-elf/sys-include/wchar.h:6,
                 from /Users/userx/.platformio/packages/toolchain-xtensa-esp32/xtensa-esp32-elf/include/c++/12.2.0/cwchar:44,
                 from /Users/userx/.platformio/packages/toolchain-xtensa-esp32/xtensa-esp32-elf/include/c++/12.2.0/bits/postypes.h:40,
                 from /Users/userx/.platformio/packages/toolchain-xtensa-esp32/xtensa-esp32-elf/include/c++/12.2.0/iosfwd:40,
                 from /Users/userx/.platformio/packages/toolchain-xtensa-esp32/xtensa-esp32-elf/include/c++/12.2.0/ios:38,
                 from /Users/userx/.platformio/packages/toolchain-xtensa-esp32/xtensa-esp32-elf/include/c++/12.2.0/ostream:38,
                 from /Users/userx/.platformio/packages/toolchain-xtensa-esp32/xtensa-esp32-elf/include/c++/12.2.0/bits/unique_ptr.h:41,
                 from /Users/userx/.platformio/packages/toolchain-xtensa-esp32/xtensa-esp32-elf/include/c++/12.2.0/memory:76,
                 from /Users/userx/.platformio/packages/framework-arduinoespressif32@src-cdf0adb896be2b73de7b8a8d60c8dc56/libraries/FS/src/FS.h:24,
                 from /Users/userx/.platformio/packages/framework-arduinoespressif32@src-cdf0adb896be2b73de7b8a8d60c8dc56/libraries/LittleFS/src/LittleFS.h:17,
                 from src/net-control.cpp:7:
/Users/userx/.platformio/packages/framework-arduinoespressif32@src-cdf0adb896be2b73de7b8a8d60c8dc56/tools/esp32-arduino-libs/esp32/dio_qspi/include/sdkconfig.h:314: note: this is the location of the previous definition
  314 | #define CONFIG_BT_NIMBLE_ROLE_CENTRAL 1
      |
.pio/libdeps/ESP32_TTGO_DISPLAY/NimBLE-Arduino/src/nimconfig.h:158: warning: "CONFIG_BT_NIMBLE_ROLE_OBSERVER" redefined
  158 | #define CONFIG_BT_NIMBLE_ROLE_OBSERVER
      |
/Users/userx/.platformio/packages/framework-arduinoespressif32@src-cdf0adb896be2b73de7b8a8d60c8dc56/tools/esp32-arduino-libs/esp32/dio_qspi/include/sdkconfig.h:317: note: this is the location of the previous definition
  317 | #define CONFIG_BT_NIMBLE_ROLE_OBSERVER 1
      |
.pio/libdeps/ESP32_TTGO_DISPLAY/NimBLE-Arduino/src/nimconfig.h:162: warning: "CONFIG_BT_NIMBLE_ROLE_PERIPHERAL" redefined
  162 | #define CONFIG_BT_NIMBLE_ROLE_PERIPHERAL
      |
/Users/userx/.platformio/packages/framework-arduinoespressif32@src-cdf0adb896be2b73de7b8a8d60c8dc56/tools/esp32-arduino-libs/esp32/dio_qspi/include/sdkconfig.h:315: note: this is the location of the previous definition
  315 | #define CONFIG_BT_NIMBLE_ROLE_PERIPHERAL 1
      |
.pio/libdeps/ESP32_TTGO_DISPLAY/NimBLE-Arduino/src/nimconfig.h:166: warning: "CONFIG_BT_NIMBLE_ROLE_BROADCASTER" redefined
  166 | #define CONFIG_BT_NIMBLE_ROLE_BROADCASTER
      |
/Users/userx/.platformio/packages/framework-arduinoespressif32@src-cdf0adb896be2b73de7b8a8d60c8dc56/tools/esp32-arduino-libs/esp32/dio_qspi/include/sdkconfig.h:316: note: this is the location of the previous definition
  316 | #define CONFIG_BT_NIMBLE_ROLE_BROADCASTER 1
      |
.pio/libdeps/ESP32_TTGO_DISPLAY/NimBLE-Arduino/src/nimconfig.h:234: warning: "CONFIG_BT_NIMBLE_ACL_BUF_COUNT" redefined
  234 | #define CONFIG_BT_NIMBLE_ACL_BUF_COUNT 12
      |
/Users/userx/.platformio/packages/framework-arduinoespressif32@src-cdf0adb896be2b73de7b8a8d60c8dc56/tools/esp32-arduino-libs/esp32/dio_qspi/include/sdkconfig.h:783: note: this is the location of the previous definition
  783 | #define CONFIG_BT_NIMBLE_ACL_BUF_COUNT CONFIG_BT_NIMBLE_TRANSPORT_ACL_FROM_LL_COUNT
      |
.pio/libdeps/ESP32_TTGO_DISPLAY/NimBLE-Arduino/src/nimconfig.h:237: warning: "CONFIG_BT_NIMBLE_ACL_BUF_SIZE" redefined
  237 | #define CONFIG_BT_NIMBLE_ACL_BUF_SIZE 255
      |
/Users/userx/.platformio/packages/framework-arduinoespressif32@src-cdf0adb896be2b73de7b8a8d60c8dc56/tools/esp32-arduino-libs/esp32/dio_qspi/include/sdkconfig.h:784: note: this is the location of the previous definition
  784 | #define CONFIG_BT_NIMBLE_ACL_BUF_SIZE CONFIG_BT_NIMBLE_TRANSPORT_ACL_SIZE
      |
.pio/libdeps/ESP32_TTGO_DISPLAY/NimBLE-Arduino/src/nimconfig.h:243: warning: "CONFIG_BT_NIMBLE_HCI_EVT_BUF_SIZE" redefined
  243 | #  define CONFIG_BT_NIMBLE_HCI_EVT_BUF_SIZE 70
      |
/Users/userx/.platformio/packages/framework-arduinoespressif32@src-cdf0adb896be2b73de7b8a8d60c8dc56/tools/esp32-arduino-libs/esp32/dio_qspi/include/sdkconfig.h:785: note: this is the location of the previous definition
  785 | #define CONFIG_BT_NIMBLE_HCI_EVT_BUF_SIZE CONFIG_BT_NIMBLE_TRANSPORT_EVT_SIZE
      |
.pio/libdeps/ESP32_TTGO_DISPLAY/NimBLE-Arduino/src/nimconfig.h:247: warning: "CONFIG_BT_NIMBLE_HCI_EVT_HI_BUF_COUNT" redefined
  247 | #define CONFIG_BT_NIMBLE_HCI_EVT_HI_BUF_COUNT 30
      |
/Users/userx/.platformio/packages/framework-arduinoespressif32@src-cdf0adb896be2b73de7b8a8d60c8dc56/tools/esp32-arduino-libs/esp32/dio_qspi/include/sdkconfig.h:786: note: this is the location of the previous definition
  786 | #define CONFIG_BT_NIMBLE_HCI_EVT_HI_BUF_COUNT CONFIG_BT_NIMBLE_TRANSPORT_EVT_COUNT
      |
.pio/libdeps/ESP32_TTGO_DISPLAY/NimBLE-Arduino/src/nimconfig.h:250: warning: "CONFIG_BT_NIMBLE_HCI_EVT_LO_BUF_COUNT" redefined
  250 | #define CONFIG_BT_NIMBLE_HCI_EVT_LO_BUF_COUNT 8
      |
/Users/userx/.platformio/packages/framework-arduinoespressif32@src-cdf0adb896be2b73de7b8a8d60c8dc56/tools/esp32-arduino-libs/esp32/dio_qspi/include/sdkconfig.h:787: note: this is the location of the previous definition
  787 | #define CONFIG_BT_NIMBLE_HCI_EVT_LO_BUF_COUNT CONFIG_BT_NIMBLE_TRANSPORT_EVT_DISCARD_COUNT
      |
src/hardware.cpp:122:1: error: 'GPIOExtenderAW9523' does not name a type
  122 | GPIOExtenderAW9523 GPIOExtender(I2C_0);
      | ^~~~~~~~~~~~~~~~~~
src/hardware.cpp: In function 'void reedSwitch_ISR()':
src/hardware.cpp:319:5: warning: '++' expression of 'volatile'-qualified type is deprecated [-Wvolatile]
  319 |     revCount++;
      |     ^~~~~~~~
src/hardware.cpp:320:21: warning: compound assignment with 'volatile'-qualified left operand is deprecated [-Wvolatile]
  320 |     workoutDistance += configTreadmill.belt_distance;
      |     ~~~~~~~~~~~~~~~~^~~~~~~~~~~~~~~~~~~~~~~~~~~~~~~~
src/hardware.cpp:321:25: warning: compound assignment with 'volatile'-qualified left operand is deprecated [-Wvolatile]
  321 |     accumulatorInterval += test_elapsed;
      |     ~~~~~~~~~~~~~~~~~~~~^~~~~~~~~~~~~~~
src/hardware.cpp: In function 'void loopHandleHardware()':
src/hardware.cpp:432:3: error: 'GPIOExtender' was not declared in this scope
  432 |   GPIOExtender.scanButtons();
      |   ^~~~~~~~~~~~
src/hardware.cpp:456:27: warning: using value of simple assignment with 'volatile'-qualified left operand is deprecated [-Wvolatile]
  456 |       t1_valid = t2_valid = false;
      |                  ~~~~~~~~~^~~~~~~
src/hardware.cpp: In function 'void handleEvent(EventType)':
src/hardware.cpp:474:7: error: 'GPIOExtender' was not declared in this scope
  474 |   if (GPIOExtender.pressEvent(event)) return;
      |       ^~~~~~~~~~~~
src/hardware.cpp: In function 'void initGPIOExtender()':
src/hardware.cpp:503:11: error: 'GPIOExtender' was not declared in this scope; did you mean 'initGPIOExtender'?
  503 |   while (!GPIOExtender.begin())
      |           ^~~~~~~~~~~~
      |           initGPIOExtender
src/hardware.cpp: At global scope:
src/hardware.cpp:512:6: error: 'GPIOExtenderAW9523' has not been declared
  512 | void GPIOExtenderAW9523::scanButtons(void)
      |      ^~~~~~~~~~~~~~~~~~
src/hardware.cpp: In function 'void scanButtons()':
src/hardware.cpp:514:7: error: 'enabled' was not declared in this scope
  514 |   if (enabled) {
      |       ^~~~~~~
src/hardware.cpp:516:21: error: 'getPins' was not declared in this scope
  516 |     uint16_t pins = getPins();
      |                     ^~~~~~~
src/hardware.cpp:523:17: error: 'AW9523_KEY_UP' was not declared in this scope
  523 |     if ((keys & AW9523_KEY_UP) && AW9523_KEY_UP) {
      |                 ^~~~~~~~~~~~~
src/hardware.cpp:528:17: error: 'AW9523_KEY_LEFT' was not declared in this scope
  528 |     if ((keys & AW9523_KEY_LEFT) && AW9523_KEY_LEFT) {
      |                 ^~~~~~~~~~~~~~~
src/hardware.cpp:533:17: error: 'AW9523_KEY_DOWN' was not declared in this scope
  533 |     if ((keys & AW9523_KEY_DOWN) && AW9523_KEY_DOWN) {
      |                 ^~~~~~~~~~~~~~~
src/hardware.cpp:538:17: error: 'AW9523_KEY_RIGHT' was not declared in this scope
  538 |     if ((keys & AW9523_KEY_RIGHT) && AW9523_KEY_RIGHT) {
      |                 ^~~~~~~~~~~~~~~~
*** [.pio/build/ESP32_TTGO_DISPLAY/src/gui-LVGL.cpp.o] Error 1
src/hardware.cpp:543:17: error: 'AW9523_KEY_OK' was not declared in this scope
  543 |     if ((keys & AW9523_KEY_OK) && AW9523_KEY_OK) {
      |                 ^~~~~~~~~~~~~
src/hardware.cpp:548:17: error: 'AW9523_KEY_BACK' was not declared in this scope
  548 |     if ((keys &
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
