lefty01/ESP32_TTGO_FTMS/doc/devboard/Schematic_DEVBOARD_ESP32_TTGO_T4_T-Display_FTMS.pdf

## U6 AMS 117 3.3V

# Add 9V or 5V Add jumpers here remove if you plug in USB

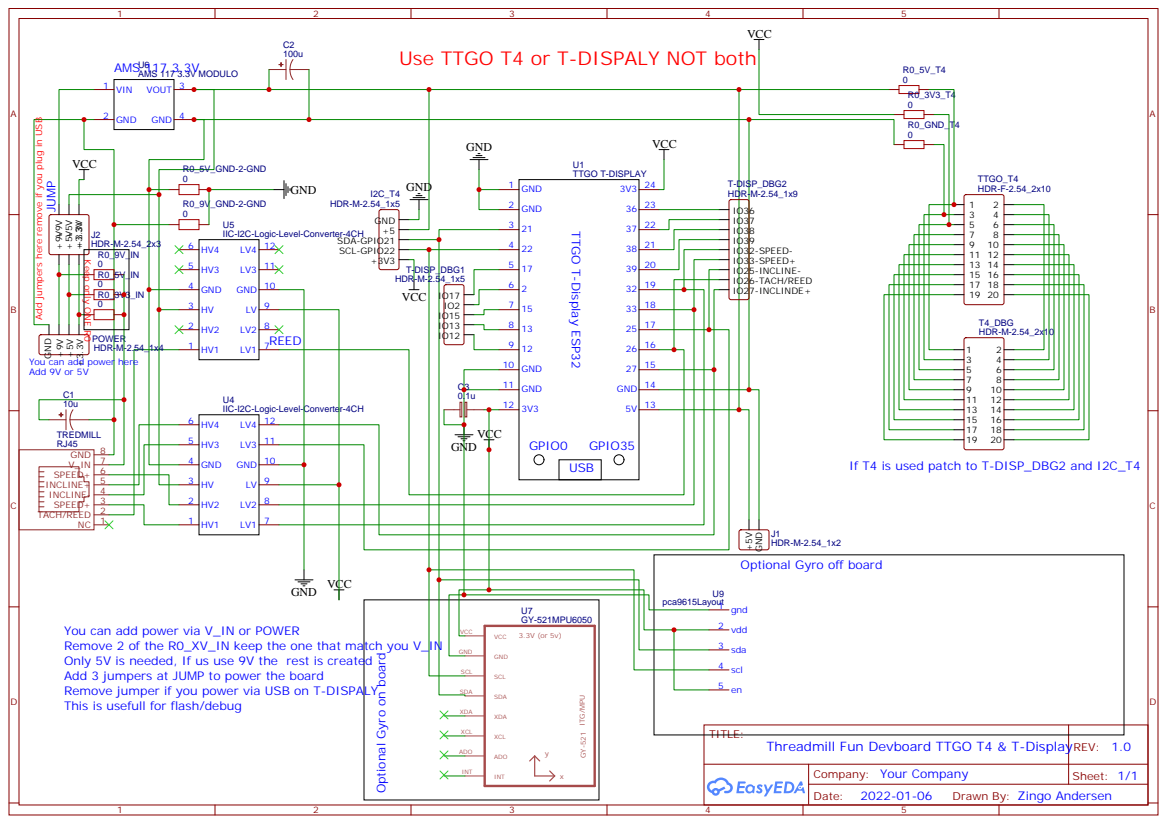
[picture p7: page 1]

Use TTGO T4 or T-DISPALY NOT both

You can add power here

If T4 is used patch to T-DISP_DBG2 and I2C_T4

You can add power via V_IN or POWER
Remove 2 of the R0_XV_IN keep the one that match you V_IN
Only 5V is needed, If us use 9V the rest is created
Add 3 jumpers at JUMP to power the board
Remove jumper if you power via USB on T-DISPALY
This is usefull for flash/debug

Optional Gyro on board

Threadmill Fun Devboard TTGO T4 & T-DisplayREV: 1.0

Drawn By: Zingo Andersen
