lefty01/ESP32_TTGO_FTMS/doc/devboard/Schematic_Gyroboard.pdf

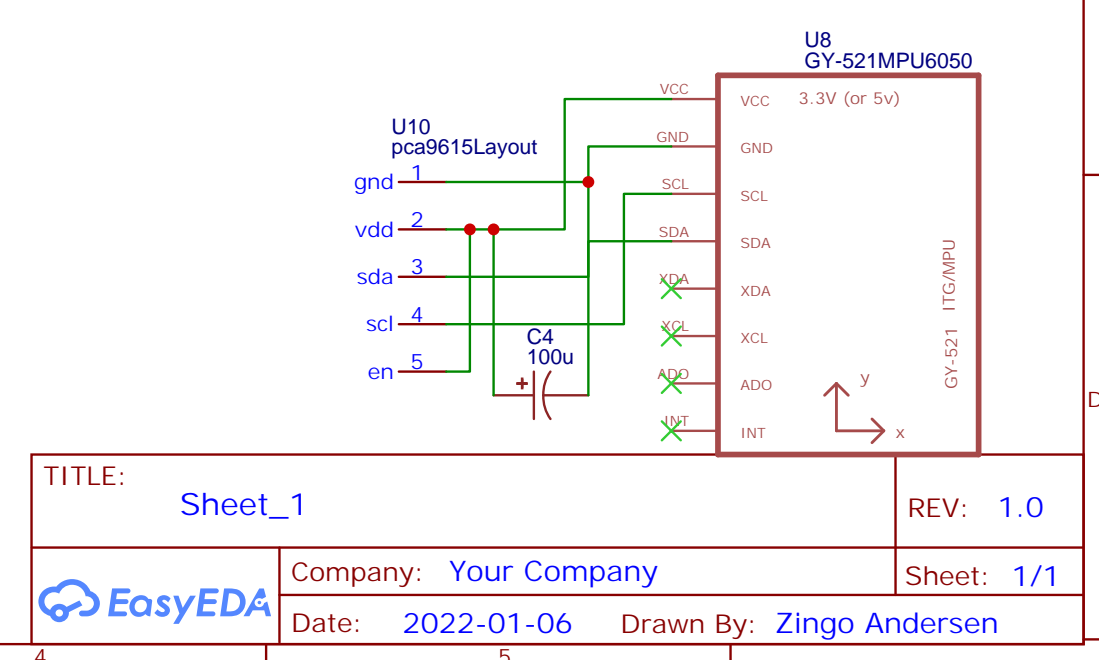
[picture p8: page 1]

Drawn By: Zingo Andersen
