lefty01/ESP32_TTGO_FTMS/src/hardware.cpp

/**
 *
 *
 * The MIT License (MIT)
 * Copyright © 2022,2025,2026 <Andreas Loeffler> <Zingo Andersen>
 *
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
 * THE SOFTWARE IS PROVIDED “AS IS”, WITHOUT WARRANTY OF ANY KIND, EXPRESS OR IMPLIED, INCLUDING
 * BUT NOT LIMITED TO THE WARRANTIES OF MERCHANTABILITY, FITNESS FOR A PARTICULAR PURPOSE AND
 * NONINFRINGEMENT. IN NO EVENT SHALL THE AUTHORS OR COPYRIGHT HOLDERS BE LIABLE FOR ANY CLAIM,
 * DAMAGES OR OTHER LIABILITY, WHETHER IN AN ACTION OF CONTRACT, TORT OR OTHERWISE, ARISING
 * FROM, OUT OF OR IN CONNECTION WITH THE SOFTWARE OR THE USE OR OTHER DEALINGS IN THE SOFTWARE.
 */

#include <Arduino.h>
#include <Button2.h>
#include <MPU6050_light.h> // accelerometer and gyroscope -> measure incline
#include <Wire.h>

#include "common.h"
#include "config.h"
#include "debug_print.h"
#include "display.h"
#include "hardware.h"
#include "net-control.h"

esp_reset_reason_t reset_reason;
unsigned long sw_timer_clock = 0;

// IRSensor - interrupt sensors to measure speed on GPIO:
#define SPEED_IR_SENSOR1   15
#define SPEED_IR_SENSOR2   13
volatile unsigned long t1;
volatile unsigned long t2;
volatile bool t1_valid = false;
volatile bool t2_valid = false;

bool timer_tick; // Every second
static constexpr int AW9523_INTERRUPT_PIN  = 25; // GPIO Extender interrupt
static constexpr int SPEED_REED_SWITCH_PIN = 26; // REED-Contact

volatile unsigned long startTime = 0;     // start of revolution in microseconds
volatile unsigned long longpauseTime = 0; // revolution time with no reed-switch interrupt
volatile long accumulatorInterval = 0;    // time sum between display during intervals
volatile unsigned int revCount = 0;       // number of revolutions since last display update
volatile long accumulator4 = 0;           // sum of last 4 rpm times over 4 seconds
volatile long workoutDistance = 0; // FIXME: vs. total_dist ... select either reed/ir/manual

// PINS
// NOTE TTGO T-DISPAY GPIO 36,37,38,39 can only be input pins https://github.com/Xinyuan-LilyGO/TTGO-T-Display/issues/10

// ttgo tft: 33, 25, 26, 27
// the number of the pushbutton pins

#if TARGET_TTGO_T_DISPLAY
// TTGO T-Display buttons
#define BUTTON_1 35
#define BUTTON_2  0
#elif TARGET_WT32_SC01
// This is a touch screen so there is no buttons
// IO_21 and IO_22 are routed out and use used for SPI to the screen
// Pins with names that start with J seems to be connected so screen, take care to avoid.
#elif TARGET_TTGO_T4
// no-touch screen with three buttons
#define BUTTON_1 38  // LEFT
#define BUTTON_2 37  // CENTRE
#define BUTTON_3 39  // RIGHT
#elif TARGET_WT32_WROOMD
// no display or buttons, web only
#else
#error Unknown button setup
#endif

#ifdef BUTTON_1
Button2 btn1(BUTTON_1);
#endif
#ifdef BUTTON_2
Button2 btn2(BUTTON_2);
#endif
#ifdef BUTTON_3
Button2 btn3(BUTTON_3);
#endif

#if TARGET_TTGO_T_DISPLAY
static const int SDA_0 = 21;
static const int SCL_0 = 22;
static const uint32_t I2C_FREQ = 400000;
#elif TARGET_WT32_SC01
// This is a touch screen so there is no buttons
// IO_21 and IO_22 are routed out and use used for SPI to the screen
// Pins with names that start with J seems to be connected so screen, take care to avoid.
static const int SDA_0 = 18;
static const int SCL_0 = 19;
static const uint32_t I2C_FREQ = 400000;
#elif TARGET_TTGO_T4
static const int SDA_0 = 21;
static const int SCL_0 = 22;
static const uint32_t I2C_FREQ = 400000;
#elif TARGET_WT32_WROOMD
// no display or buttons, web only
static const int SDA_0 = 18;
static const int SCL_0 = 19;
static const uint32_t I2C_FREQ = 400000;
#else
#error Unknown HW Platform
#endif

//csstatic TwoWire I2C_0 = TwoWire(0);
TwoWire I2C_0 = TwoWire(0);

static MPU6050 mpu6050(I2C_0);

//cs static GPIOExtenderAW9523 GPIOExtender(I2C_0);
GPIOExtenderAW9523 GPIOExtender(I2C_0);

void btn1TapHandler(Button2& b)
{
  unsigned int time = b.wasPressedFor();
  DEBUG_PRINTLN("Button 1 TapHandler");

  if (time > 3000) {
   // > 3sec enters config menu
    DEBUG_PRINTLN("RESET timer/counter!");
    doReset();
  }
  else if (time > 600) {
    DEBUG_PRINTLN("Button 1 long click...");
    // reset to manual mode
    speedInclineMode = MANUAL;
    DEBUG_PRINT("speedInclineMode=");
      DEBUG_PRINTLN(speedInclineMode);
#ifndef NO_DISPLAY
    gfxUpdateHeader();
#endif
  }
  else {
    // button1 short click toggle speed/incline mode
    DEBUG_PRINTLN("Button 1 short click...");
    speedInclineMode += 1;
    speedInclineMode &= SPEEDINCLINE_BITFIELD; //wrap around MANUAL,SPEED,INCLINE,SPEED & INCLINE
    DEBUG_PRINT("speedInclineMode=");
    DEBUG_PRINTLN(speedInclineMode);
#ifndef NO_DISPLAY
    gfxUpdateHeader();
#endif
  }
}

void btn2TapHandler(Button2& b)
{
  unsigned int time = b.wasPressedFor();
  DEBUG_PRINTLN("Button 2 TapHandler");

  if (time > 3000) { // > 3sec enters config menu
    //DEBUG_PRINTLN("very long (>3s) click ... do nothing");
  }
  else if (time > 500) {
    DEBUG_PRINTLN("long (>500ms) click...");
    if ((speedInclineMode & SPEED) == 0) {
      speedDown();
    }
    if ((speedInclineMode & INCLINE) == 0) {
      inclineDown();
    }
  }
  else {
    DEBUG_PRINTLN("short click...");
    if ((speedInclineMode & SPEED) == 0) {
      speedUp();
    }
    if ((speedInclineMode & INCLINE) == 0) {
      inclineUp();
    }
  }
}


void btn3TapHandler(Button2& b)
{
  unsigned int time = b.wasPressedFor();
  DEBUG_PRINTLN("Button 3 TapHandler");
  if (time > 3000) {
    // DEBUG_PRINTLN("very long (>3s) click ... do nothing");
  }
  else {
    DEBUG_PRINTLN("short click...");
    if ((speedInclineMode & SPEED) == 0) {
      speedDown();
    }
    if ((speedInclineMode & INCLINE) == 0) {
      inclineDown();
    }
  }
}

void loopHandleButton()
{
#ifdef BUTTON_1
  btn1.loop();
#endif
#ifdef BUTTON_2
  btn2.loop();
#endif
#ifdef BUTTON_3
    btn3.loop();
#endif
}

void initButton()
{
  logText("initButton...");
#ifdef BUTTON_1
  // button 1 (GPIO 0) control auto/manual mode and reset timers
  btn1.setTapHandler(btn1TapHandler);
#endif

  // if only two buttons, then button 1 switches mode and button 2 short is up, button 2 long is down
  // if three buttons use button 2 short as up and button 3 short as down
  // fixme: keep button2 long handler for now does not hurt
  // initially for testing purpose ... but if we can access the controller while running it can serve as backup
  // if sensors fail or suddnely send incorrect readings (yeah that happend to me) ... but since the controller
  // might not be accessable we have the web interface that can run on the smartphone
#ifdef BUTTON_2
  // short  click = up
  // longer click = down
  btn2.setTapHandler(btn2TapHandler);
 #endif

#ifdef BUTTON_3
  // short  click = down
  btn3.setTapHandler(btn3TapHandler);
#endif
  logText("done\n");
}

void delayWithDisplayUpdate(unsigned long delayMilli)
{
  unsigned long timeStartMilli = millis();
  unsigned long currentMilli = timeStartMilli;
  while((currentMilli - timeStartMilli) < delayMilli) {
#warning todo cs: add gxloop handler again.
//    gfxUpdateLoopHandler();
    unsigned long timeLeftMilli = delayMilli - (currentMilli - timeStartMilli) ;
    if (timeLeftMilli >= 5 ) {
      delay(5);
    }
    else {
      delay(timeLeftMilli);
    }
    currentMilli = millis();
  }
}

void initSensors(void)
{
  if (configTreadmill.hasMPU6050) {
    // Mesure incline using angle "detector" MPU6050
    logText("init MPU6050....");

    I2C_0.begin(SDA_0, SCL_0, I2C_FREQ);
    byte status = mpu6050.begin();
    DEBUG_PRINT("status: ");
    DEBUG_PRINT(status);

    if (status != 0) {
      logText(" failed (DISABLED)\n");
      configTreadmill.hasMPU6050 = false;
      // TODO Would we want to retry, now, later, by config or is power off/on good enough
    }
    else {
      logText("Calc offsets, do not move MPU6050 (3sec)");

      mpu6050.calcOffsets(); // gyro and accel.
      delayWithDisplayUpdate(2000);
      speedInclineMode |= INCLINE;

      logText(" done\n");
    }
//    I2C_0.end();
  }
}
// ------------------ Mesure speed with something triggering a GPIO pin periodicle
// Triggered periodiacly according to speed, could be a HAL sensor on the front roller of the treadmill
// Might be a signal found in your treadmill cable harnest
void IRAM_ATTR reedSwitch_ISR()
{
  // calculate the microseconds since the last interrupt.
  // Interupt activates on falling edge.
  uint32_t usNow = micros();
  uint32_t test_elapsed = usNow - startTime;

  // handle button bounce (ignore if less than 300 microseconds since last interupt)
  if (test_elapsed < 300) {
    return;
  }

  //if (test_elapsed > 1000000) {
  if (test_elapsed > 1000000) {  // assume the treadmill isn't spinning in 1 second.
    startTime = usNow; // reset the clock;
    longpauseTime = 0;
    return;
  }
  if (test_elapsed > longpauseTime / 2) {
    // acts as a debounce, don't looking for interupts soon after the first hit.
    //DEBUG_PRINT(test_elapsed); //DEBUG_PRINTLN(" Counted");

    startTime = usNow;  // reset the clock
    //long elapsed = test_elapsed;
    longpauseTime = test_elapsed;

    revCount++;
    workoutDistance += configTreadmill.belt_distance;
    accumulatorInterval += test_elapsed;
  }
}

// ------------------ Mesure speed with something 2 triggers on GPIO pin periodicle like a marker on the loop?
// Messure two IR-Sensors
static void IRAM_ATTR speedSensor1_ISR(void)
{
  if (! t1_valid) {
    t1 = micros();
    t1_valid = true;
  }
}

static void IRAM_ATTR speedSensor2_ISR(void)
{
  if (t1_valid && !t2_valid) {
    t2 = micros();
    t2_valid = true;
  }
}

// angleSensorTreadmillConversion()
// If a treadmill has some special placement of the angle sensor
// here is where that value is converted from sensor read to proper angle of running area.

double angleSensorTreadmillConversion(double inAngle) {
  double convertedAngle = inAngle;

  if (configTreadmill.hasMPU6050inAngle) {

    /* If Sensor is placed in inside the treadmill engine
      TODO: Maybe this can be automatic, e.g. Let user selct a incline at a time
            and record values and select inbeween bounderies.
            If treadmill support stearing the incline maybe it can also be an automatic
            calibration step. e.g. move it max down, callibrate sensor, step up max and measure
            User input treadmill "Max incline" value and Running are length somehow.
                /|--- ___
            c / |        --- ___ a
              /  |x              --- ___  Running area
            /   |_                      --- ___
            / A  | |                           C ---  ___

      A = inAngle (but we want the angle C)
      sin(A)=x/c     sin(C)=x/a
      x=c*sin(A)     x=a*sin(C)
      C=asin(c*sin(A)/a)
    */
    double c = 32.0;  // lenght of motor part in cm TODO treadmill config?
    double a = 150.0; // lenght of running area in cm TODO treadmill config?
    convertedAngle = asin(c*sin(inAngle * DEG_TO_RAD)/a) * RAD_TO_DEG;
  }
  return convertedAngle;
}

// getIncline()
// This will read the used "incline" sensor, run this periodically
// The following global variables will be updated
//    angle - the angle of the running are
//    incline - the incline value (% of angle between 0 and 45 degree)
//              incline is usally the value shown by your treadmill.
float getIncline(void)
{
  double sensorAngle = 0.0;
  float temp_incline = 0.0;

  if (configTreadmill.hasMPU6050) {
    // MPU6050 returns a incline/grade in degrees(!)
    // FIXME: maybe get some rolling-average of Y-angle to smooth things a bit (same for speed)
    // mpu.getAngle[XYZ]
    sensorAngle = mpu6050.getAngleY(); //This does not use I2C no need to I2C begin/end

    angle = angleSensorTreadmillConversion(sensorAngle); // convert angle depending placment of mpu6050 on treadmill

    if (angle < 0) angle = 0; // TODO We might allow running downhill, some threadmill support it and pratically
                              //      you could put something under it on the back side

    char yStr[5];
    snprintf(yStr, 5, "%.2f", angle);

    temp_incline = tan(angle * DEG_TO_RAD) * 100;
    char inclineStr[6];
    snprintf(inclineStr, 6, "%.1f", temp_incline);

    //client.publish(getTopic(MQTT_TOPIC_Y_ANGLE), yStr);
#warning check out if this must be here ******************
    // CS WHY IS THIS HERE
    // AL: my idea was to eventually visualize data somewhere else if it is received by mqtt
    //client.publish(getTopic(MQTT_TOPIC_INCLINE), inclineStr);
    // ******************************************
  }

  if (temp_incline <= configTreadmill.min_incline) temp_incline = configTreadmill.min_incline;
  if (temp_incline > configTreadmill.max_incline)  temp_incline = configTreadmill.max_incline;

#warning cs todo remove this
  DEBUG_PRINTF("sensor angle (%.2f): used angle: %.2f: -> incline: %f%%\n", sensorAngle, angle, temp_incline);

  // TODO probably need some more smoothing here ...
  return temp_incline;
}

void loopHandleHardware(void)
{
  // NOTE/WARNING:
  // MPU6050 (mpu) and GPIOExtender use twowire i2c driver and LovyanGFX has it's own
  // This makes the twowire collide in some way and you get a 1s delay after each touch
  // on the screen. To solve this collition of the i2c HW LovyanGFX code shoule be placed
  // outside of the I2C_0.begin/end below that surrounds MPU6050 (mpu), GPIOExtender class
  // is part of our code hand has it's own I2C_0.begin() and I2C_0.end() when using I2C

  GPIOExtender.scanButtons();

  if ((millis() - sw_timer_clock) > EVERY_SECOND) {
    sw_timer_clock = millis();
    timer_tick = true;
  }

  if (configTreadmill.hasMPU6050) {
    I2C_0.begin(SDA_0 , SCL_0 , I2C_FREQ);
    mpu6050.update();  // read out data from the sensor
//    I2C_0.end();
  }

  // IrSensor to check speed
  if (configTreadmill.hasIrSense) {
    unsigned long t;
#warning remove this constant to some config/file
    const unsigned long c = 359712; // d=10cm
    t = t2 - t1;
    // check ir-speed sensor if not manual mode
    if (t2_valid) {
     // hasIrSense = detected
      kmphIRsense = (float)(1.0 / t) * c;
      noInterrupts();
      t1_valid = false;
      t2_valid = false;
      interrupts();
      DEBUG_PRINTF("IrSense: t=%li kmph_sense=%f\n",t,kmphIRsense);
    }
  }
}

// A simple event handler, currenly just a call stack, an event queue would be smarter
// but this solves the problem as a start, not sure it we really have the usecase where
// we need a queue, lets add it in that case

void handleEvent(EventType event)
{
  // Add more event handlers here in prio order, checking if handled before running
  // each handle will return true is event is handled so we can stop the event check
  // in that case.
  // Currently there is no queue so if Events are translated to new events and call
  // handleEvent() to post them take care to not get into loops.
  if (GPIOExtender.pressEvent(event)) return;

  DEBUG_PRINTF("handleEvent() Cant handle Event:0x%x\n",static_cast<uint32_t>(event));
  return;
}
float calculateRPM(void)
{
  float temp_rpm = 0;

  if (configTreadmill.hasReed) {
    if (revCount > 0) {
     // confirm there was at least one spin in the last second
      noInterrupts();
      temp_rpm = 60000000 / (accumulatorInterval / revCount);
      revCount = 0;
      accumulatorInterval = 0;
      interrupts();
    }
  }
  else {
    temp_rpm = 0;
    //rpmaccumulatorInterval = 0;
    //accumulator4 = 0;  // average rpm of last 4 samples
  }
  return temp_rpm;
}

static void initGPIOExtender(void) {
  logText("initGPIOExtender...");
  while (!GPIOExtender.begin()) {
    DEBUG_PRINTLN("GPIOExtender not found");
    return;
  }

  logText("done\n");
}

void GPIOExtenderAW9523::scanButtons(void)
{
  if (enabled) {
    static uint16_t prevKeys = 0;
    uint16_t pins = getPins();
    uint16_t keys = ((~pins) & 0x3f );

    if ( keys != prevKeys) {
    // New key status
    //DEBUG_PRINTF("GPIOExtender KEY IN:0x%x (0x%x)\n",keys,pins);

    if ((keys & AW9523_KEY_UP) && AW9523_KEY_UP) {
      DEBUG_PRINTLN("AW9523_KEY_UP");
      handleEvent(EventType::KEY_UP);
      //handleEvent(EventType::TREADMILL_INC_UP);
    }
    if ((keys & AW9523_KEY_LEFT) && AW9523_KEY_LEFT) {
      DEBUG_PRINTLN("AW9523_KEY_LEFT");
      handleEvent(EventType::KEY_LEFT);
      //handleEvent(EventType::TREADMILL_SPEED_DOWN);
    }
    if ((keys & AW9523_KEY_DOWN) && AW9523_KEY_DOWN) {
      DEBUG_PRINTLN("AW9523_KEY_DOWN");
      handleEvent(EventType::KEY_DOWN);
      //handleEvent(EventType::TREADMILL_INC_DOWN);
    }
    if ((keys & AW9523_KEY_RIGHT) && AW9523_KEY_RIGHT) {
      DEBUG_PRINTLN("AW9523_KEY_RIGHT");
      handleEvent(EventType::KEY_RIGHT);
      //handleEvent(EventType::TREADMILL_SPEED_UP);
    }
    if ((keys & AW9523_KEY_OK) && AW9523_KEY_OK) {
      DEBUG_PRINTLN("AW9523_KEY_OK");
      handleEvent(EventType::KEY_OK);
      //handleEvent(EventType::TREADMILL_START);
    }
    if ((keys & AW9523_KEY_BACK) && AW9523_KEY_BACK) {
      DEBUG_PRINTLN("AW9523_KEY_BACK");
      handleEvent(EventType::KEY_BACK);
      //handleEvent(EventType::TREADMILL_STOP);
    }

    if ((keys & 0xffc0)  != 0)  DEBUG_PRINTF("Non key pins: 0x%x\n",keys);
    prevKeys = keys;
    }
  }
}

void GPIOExtenderAW9523::logPins(void)
{
  if (enabled) {
      uint8_t port0 = read(INPUT_PORT0);
      uint8_t port1 = read(INPUT_PORT1);
      DEBUG_PRINTF("GPIOExtenderAW9523 Read port:0x%x%x\n",port1,port0);
  }
}

// Currently only support one button at time
bool GPIOExtenderAW9523::pressEvent(EventType eventButton)
{
  DEBUG_PRINTF("GPIOExtenderAW9523: pressEvent(0x%x)\n", static_cast<uint32_t>(eventButton));
  if (enabled) {
    // convert event to HW line
    uint16_t line = -1;
    switch (eventButton) {
      case EventType::TREADMILL_START:      line = AW9523_TREADMILL_START; break;
      case EventType::TREADMILL_SPEED_DOWN: line = AW9523_TREADMILL_SPEED_DOWN; break;
      case EventType::TREADMILL_INC_DOWN:   line = AW9523_TREADMILL_INC_DOWN; break;
      case EventType::TREADMILL_STOP:       line = AW9523_TREADMILL_STOP; break;
      case EventType::TREADMILL_SPEED_UP:   line = AW9523_TREADMILL_SPEED_UP; break;
      case EventType::TREADMILL_INC_UP:     line = AW9523_TREADMILL_INC_UP; break;
      default:
        // Cant handle Event
        DEBUG_PRINTF("GPIOExtenderAW9523 ERROR: Unknown event 0x%x\n", static_cast<uint32_t>(eventButton));
        return false;
    }
    if (line == -1) {
      DEBUG_PRINTF("GPIOExtenderAW9523 ERROR: event not converted to line 0x%x\n", static_cast<uint32_t>(eventButton));
      return false;
    }
    DEBUG_PRINTF("GPIOExtenderAW9523: pressEvent(0x%x) -> 0x%x \n", static_cast<uint32_t>(eventButton), line);

    if (line & 0xff) {
      uint8_t port0Bit = line & 0xff;
      DEBUG_PRINTF("GPIOExtenderAW9523: pressEvent(0x%x) -> 0x%x port0=0x%x ~x%x\n", static_cast<uint32_t>(eventButton),
                   line, port0Bit, ~port0Bit);

      // pinMode(pin, OUTPUT);
      if (!write(CONFIG_PORT0, ~port0Bit)) return false; //0-output 1-input
      // digitalWrite(pin, LOW);
      if (!write(OUTPUT_PORT0, ~port0Bit)) return false; //0-low 1-high

#warning Remove delay and schedule last part later in some way and go back to "main" loop mode.
      delay(TREADMILL_BUTTON_PRESS_SIGNAL_TIME_MS);

      // digitalWrite(pin, HIGH);
      if (!write(OUTPUT_PORT0, 0xff)) return false; //0-low 1-high
      // pinMode(pin, INPUT);
      if (!write(CONFIG_PORT0, 0xff)) return false; //0-output 1-input
    }
    else {
      uint8_t port1Bit = (line & 0xff00) >> 8;
      DEBUG_PRINTF("GPIOExtenderAW9523: pressEvent(0x%x) -> 0x%x port1=0x%x ~x%x\n", static_cast<uint32_t>(eventButton),
                   line, port1Bit, ~port1Bit);
      // pinMode(pin, OUTPUT);
      if (!write(CONFIG_PORT1, ~port1Bit)) return false; //0-output 1-input
      // digitalWrite(pin, LOW);
      if (!write(OUTPUT_PORT1, ~port1Bit)) return false; //0-low 1-high

#warning Remove delay and schedule last part later in some way and go back to "main" loop mode.
      delay(TREADMILL_BUTTON_PRESS_SIGNAL_TIME_MS);

      // digitalWrite(pin, HIGH);
      if (!write(OUTPUT_PORT1, 0xff)) return false; //0-low 1-high
      // pinMode(pin, INPUT);
      if (!write(CONFIG_PORT1, 0xff)) return false; //0-output 1-input
    }
    return true;
  }
  return false;
}

uint8_t GPIOExtenderAW9523::read(uint8_t reg, bool i2cHandled)
{
  if (!i2cHandled) {
    // Warning/Info to avoid TwoWire and LovyanGFX I2C collition make sure to fullt init/deinit I2C driver states
    // around the I2C calls
    I2C_0.begin(SDA_0, SCL_0, I2C_FREQ);
  }
  wire->beginTransmission(AW9523_ADDR);
  wire->write(reg);
  wire->endTransmission(true);
  wire->requestFrom(AW9523_ADDR, static_cast<uint8_t>(1));
  uint8_t ret = wire->read();
  if (!i2cHandled) {
    //I2C_0.end();
  }
  return ret;

}

uint8_t GPIOExtenderAW9523::read(uint8_t reg)
{
  return read(reg, false);
}

bool GPIOExtenderAW9523::write(uint8_t reg, uint8_t data)
{
  // Warning/Info to avoid TwoWire and LovyanGFX I2C collition make sure to fullt init/deinit I2C driver states
  // around the I2C calls
  I2C_0.begin(SDA_0, SCL_0, I2C_FREQ);
  wire->beginTransmission(AW9523_ADDR);
  wire->write(reg);
  wire->write(data);
  uint8_t ret = wire->endTransmission();  // 0 if OK
//  I2C_0.end();
  if (ret != 0) {
    DEBUG_PRINTF("GPIOExtenderAW9523 ERROR: write reg: 0x%x value:0x%x -> Error: 0x%x\n", reg, data, ret);
    return false;
  }
  return true;
}

bool GPIOExtenderAW9523::begin()
{
  enabled = false;
  isInterrupted = false;
  uint8_t id = read(ID);
  DEBUG_PRINTF("GPIOExtenderAW9523: Read ID: 0x%x = 0x%x\n", ID, id);

  if (id != ID_AW9523) {
    return false;
  }

  if (!write(OUTPUT_PORT0, 0xff)) return false; //0-low 1-high
  if (!write(OUTPUT_PORT1, 0xff)) return false; //0-low 1-high

  // All input
  if (!write(CONFIG_PORT0, 0xff)) return false; //0-output 1-input
  if (!write(CONFIG_PORT1, 0xff)) return false; //0-output 1-input

  if (!write(CTL, 0x08)) return false; //0000x000  0-Open Drain 1-Push-Pull

  if (!write(INT_PORT0, 0xff)) return false; //0-enable 1-disable
  if (!write(INT_PORT1, 0xff)) return false; //0-enable 1-disable

  if (!write(LED_MODE_SWITCH0, 0xff)) return false; //0-LED mode 1-GPIO mode
  if (!write(LED_MODE_SWITCH1, 0xff)) return false; //0-LED mode 1-GPIO mode
  enabled = true;
  getPins();
  return true;
}

bool GPIOExtenderAW9523::isAvailable()
{
  return enabled;
}

uint16_t GPIOExtenderAW9523::getPins(void)
{
  if (enabled) {
    isInterrupted = false;
    // As this is part of main loop lets read both ports with one I2C begin/end
    // to speed thing up.
    I2C_0.begin(SDA_0, SCL_0, I2C_FREQ);

    uint8_t port0 = read(INPUT_PORT0, true);
    uint8_t port1 = read(INPUT_PORT1, true);

//    I2C_0.end();
    return ((port1 << 8) | port0);
  }
  return 0;
}

bool GPIOExtenderAW9523::checkInterrupt(void)
{
  return (enabled && isInterrupted);
}

void initHardware(void)
{
  logText("init Hardware...");
  reset_reason = esp_reset_reason();
#if defined(SPEED_IR_SENSOR1) && defined(SPEED_IR_SENSOR2)
  // pinMode(SPEED_IR_SENSOR1, INPUT_PULLUP); //TODO used?
  // pinMode(SPEED_IR_SENSOR1, INPUT_PULLUP); //TODO used?
  attachInterrupt(SPEED_IR_SENSOR1, speedSensor1_ISR, FALLING); //TODO used?
  attachInterrupt(SPEED_IR_SENSOR2, speedSensor2_ISR, FALLING); //TODO used?
#endif

  // note: I have 10k pull-up on SPEED_REED_SWITCH_PIN
  pinMode(SPEED_REED_SWITCH_PIN, INPUT);
  attachInterrupt(digitalPinToInterrupt(SPEED_REED_SWITCH_PIN), reedSwitch_ISR, FALLING);

  initGPIOExtender();
  initSensors();
}

const char* getRstReason(esp_reset_reason_t r) {
  switch(r) {
    case ESP_RST_UNKNOWN:    return "ESP_RST_UNKNOWN";   //!< Reset reason can not be determined
    case ESP_RST_POWERON:    return "ESP_RST_POWERON";   //!< Reset due to power-on event
    case ESP_RST_EXT:        return "ESP_RST_EXT";       //!< Reset by external pin (not applicable for ESP32)
    case ESP_RST_SW:         return "ESP_RST_SW";        //!< Software reset via esp_restart
    case ESP_RST_PANIC:      return "ESP_RST_PANIC";     //!< Software reset due to exception/panic
    case ESP_RST_INT_WDT:    return "ESP_RST_INT_WDT";   //!< Reset (software or hardware) due to interrupt watchdog
    case ESP_RST_TASK_WDT:   return "ESP_RST_TASK_WDT";  //!< Reset due to task watchdog
    case ESP_RST_WDT:        return "ESP_RST_WDT";       //!< Reset due to other watchdogs
    case ESP_RST_DEEPSLEEP:  return "ESP_RST_DEEPSLEEP"; //!< Reset after exiting deep sleep mode
    case ESP_RST_BROWNOUT:   return "ESP_RST_BROWNOUT";  //!< Brownout reset (software or hardware)
    case ESP_RST_SDIO:       return "ESP_RST_SDIO";      //!< Reset over SDIO
  }
  return "INVALID";
}
