lefty01/ESP32_TTGO_FTMS/(commit log)

2021-03-08 adding async server sample from hackaday.io/project/175237-add-bluetooth-to-treadmill. cleanup tft a little bit
2021-04-09 switched from breadboard to pcb removed any external buttons (except those from TTGO esp32 boars gpio0,gpio35) connectors for two ir-sensors and/or reed switch from treadmill, measure speed from reed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
    [measurement-kmh-vs-time.ods]
2021-04-13 added some incline logs from mpu gyro and tof range sensor
    [measurement-kmh-vs-time.ods]
2021-04-15 some fixes. changed gpio pins ...
    [ESP32_TTGO_FTMS.ino, tft-functions.ino]
2021-05-03 Add initial support for Icon based treadmils using MC2100els
    Use the Tach cable from the motor controller to the "Computer"
    e.g. Green cable in the cable harnst.
    Only tested on NordicTrack T12si but seem to be present on other models also
2021-05-03 add variable to toggle which incline value to return, right now for the taurus we return levels between 0-15 which is not correct if we want to get meaningful elevation gain
    [ESP32_TTGO_FTMS.ino, net-control.ino]
2021-05-03 fix pre-processor else if ... hrmm
    [ESP32_TTGO_FTMS.ino]
2021-08-07 set default mode for speed to sensor/auto (not manual)
2021-11-18 Convert project to PlatformIO
    Add support for vscode with PlatformIO plugin
    It's kind of nice to specify dependacy projects in
    platformio.ini
    Hopefully it will still build in Arduino
    [measurement-kmh-vs-time.ods]
2021-11-18 Switch to NimBLE bluetooth stack
    NimBLE takes less space so now the image is small
    enough so OTA could be added.
2021-11-19 Move data folder to root and update to TFT_eSPI 2.3.80
    Moved data folder to root so it can be easy accessed
    by platformIO tools
    Version 2.3.80 of TFT_eSPI had some problem with
    TTGO Display that was fixed in 2.3.81
    [ESP32_TTGO_FTMS.ino, tft-functions.ino]
2022-01-02 did some further rework. use .cpp extension instead of .ino add common include to provide extern definitions this code still requires some more cleanup/polish.
    [huge_app.csv]
2022-01-04 Mqttssl (#6)
    * adding support to connect to mqtt server via ssl/tls
    * readme format typo
    * update readme
    [huge_app.csv, ssl_app.csv]
2022-01-05 Combine common settings into a config block
    Common setting like compiler settings and target HW are bunched into one setting that reflect all tasks
    Also some slight fixes was done to make all task build
    [ESP32_TTGO_FTMS.cpp, net-control.cpp]
2022-01-07 did some further rework. use .cpp extension instead of .ino add common include to provide extern definitions this code still requires some more cleanup/polish.
    Author: andreas loeffler <al@exitzero.de>
    [huge_app.csv]
2022-02-02 Incline on NordicTrack and web controll of treadmill
    This adds support for treadmill models that have a folded incline mechanic where the sensor is on the front part and not on the running part.
    The webUI now controll incline and speed when HW supports it.
2022-02-03 Add schematic of devboard and gyroboard
2022-02-04 Fix treadmill selection and show setup info
    [ESP32_TTGO_FTMS.cpp]
2022-02-04 bump version. fix some whitespace (end of line mostly). open curly braces on the same line as (if) statement
    [ESP32_TTGO_FTMS.cpp, net-control.cpp]
2022-02-05 I2C fix for WT32_SC01 and disable IR_SENSOR
    On WT32_SC01 the defult I2C pin 21,22 is used as
    for the display together with the IR_SENSOR
    pins 13,15.
    This change will use I2C on 18,19 pins for WT32_SC01
    and disable the IR_SENSOR Interrup setup as
    all setups now seem to use REED sensor anyway.
    [ESP32_TTGO_FTMS.cpp]
2022-02-07 was trying to run ssl webserver. at the moment that required some patching of other code therefore including my forks via platformio. seems the overhead is too much, a simpler example is working but 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
    [ESP32_TTGO_FTMS.cpp, common.h, net-control.cpp]
2022-02-07 fix button3 down
2022-02-07 elevation gain was not reported correctly. also moved comments from src to README
    [ESP32_TTGO_FTMS.cpp, common.h]
2022-02-07 fix rebase issue (duplicated var) add T4 to the compile action
    [ESP32_TTGO_FTMS.cpp]
2022-02-08 button3 inside button loop
2022-02-08 donate button ... buy me a beer or coffee ;)
2022-02-08 work on touch buttons
2022-02-08 adjust layout for full-screen ;) ... probably need to define draw areas eg. DRAW_STATS_ and DRAW_CONTROL_ width/height, relevant for larger touch tft like the one on WT32. Fixed mqtt reconnt loop, on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
    [ESP32_TTGO_FTMS.cpp]
2022-02-16 get some touch buttons working using LGFX_Button. note: here font size of the button lable seems to change for no reason!?.
2022-02-16 fix compile for non-touch targets (aka not TARGET_WT32_SC01)
    [ESP32_TTGO_FTMS.cpp]
2022-02-16 fix non-touch tft using lgfx lib
    [ESP32_TTGO_FTMS.cpp, common.h]
2022-04-16 Remove old GPIO pin debugging
    As we have the screen and serial loga up and running this will
    probably not be used anymore, if needed it's easy to add back.
2022-04-16 Let MQTT only retry 2 times and redraw gfx after a retry
    This fix the problem that if there is no MQTT Server
    it retried forever locking up the device, also as the
    MQTT connect code clears the screen It needs to be
    redrawn after.
    A utility function was added to redraw the header as
    this was done in many places.
    [ESP32_TTGO_FTMS.cpp, net-control.cpp]
2022-04-16 Update common.h with the updateHeader()
    Fixes build error.
    [common.h]
2022-09-07 Use defined types when setting up I2C
    When wire.h was updated the begin() became ambigious
    when using #define for the const, so static const is used
    instead.
2022-09-21 fix i2c variable types also for target TARGET_TTGO_T4
    [ESP32_TTGO_FTMS.cpp]
2022-12-08 Add note/warning about i2c towire and LovyanGFX problem
2022-12-18 begin/end all I2C call between TwoWire and LovyanGFX drivers
    To avoid driver collision setup and teardown the I2C on all places
    used in the main loop.
    [ESP32_TTGO_FTMS.cpp, display.cpp, hardware.h]
2022-12-20 Code cleanup for I2C driver code
2022-12-20 Remove code and driver for VL53L0X
    VL53L0X was only half implemented lets remove it until someone actually
    needs it.
2022-12-20 Add build of ESP32_WROOMD_HEADLESS to GitHub tests
2022-12-21 Fix some issues shown in Automatic code review
    [ESP32_TTGO_FTMS.cpp, net-control.cpp]
2022-12-31 Fix build for all targets after addinf LVGL
    [gui-LVGL.cpp, gui-tft.cpp]
2023-01-01 for T4 the button2 tap handler did not work anymore (this button can act on long or short press) some "fix" of coding style i.e. for if statements place open brace at end of line not ext line (that i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
    [ESP32_TTGO_FTMS.cpp, config.cpp, net-control.cpp]
2023-01-02 Fix some code styling
    [display.cpp, gui-LVGL.cpp, gui-tft.cpp, hardware.cpp, hardware.h]
2023-01-02 Remove LVGL buttons from target without touch interface
2023-01-02 LVGL Create main screen after init
    If the screen is created before the config file is read
    the speed and incline Level meters are not setup correctly
    [gui-LVGL.cpp]
2023-01-04 palce the extension of (mqtt) device id by part of mac addr into seperate function and call before ble init (I do have sometimes more than one esp32 running so this ble identifier needs to be uniq). 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
2023-01-04 change web gui as bit, get rid of toggling icon, use switch icon to toggle manual / auto mode
2023-01-09 Make MPU6050 position configurable
    On NorthTrack12_2Si the MPU6050 is put in an angualr position
    compared to the running area.
    This can be selected by setting hasMPU6050inAngle to 1
    This solves the problem with that the code is shared, now the
    special calculation is only used when needed.
    [ESP32_TTGO_FTMS.cpp, common.h, config.cpp, config.h, hardware.cpp]
2026-01-04 various updates. step lgvl version to 9.4 seems not to work yet, gauges (now scales) not show. untested version
    [ssl_app.csv]
2026-01-04 remove compile flag to switch between spiffs and littleFS. litteFS is the defacto standard
2026-01-04 fix: timer tick increment.
    [ESP32_TTGO_FTMS.cpp, config.cpp, display.cpp, gui-LVGL.cpp]
2026-01-04 fix mem issues with some targets.
    [gui-LVGL.cpp]
2026-01-05 changed stop watch logic which was not yet working (at least no control). switch from modifying esp system time and transmitting the time to client to a browser only stop watch with auto-pause mode b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
    [ESP32_TTGO_FTMS.cpp, net-control.cpp, net-control.h]
2026-01-05 wip. this broke something :(
    [config.cpp, net-control.cpp]
2026-01-05 step version. update auto-pause toggle button state on stop
